OLIMEX/iCE40HX1K-EVB/README.md

# iCE40HX1K-EVB
FPGA development board made with KiCAD
