OLIMEX/iCE40HX1K-EVB/modules/iCE40-ADC/README.md

# Repository re-located here: https://github.com/OLIMEX/iCE40-ADC/tree/master
