OLIMEX/iCE40HX1K-EVB/demo/ice40hx1k-evb/README

This example is for iCE40HX1K-EVB board 

www.olimex.com/wiki/iCE40HX1K-EVB

you need OLIMEXINO-32U4 set as programmer to program the board
