OLIMEX/iCE40HX1K-EVB/(threads)

Thread 2 (2017-09-08):

Request guide to program FPGA board with generic Arduino

electronut, 2017-09-08:
The current documentation assumes that Olimexduino is used as a programmer with the custom cable.

This board would be much more user friendly if some guidance was provided on making it work with a generic Arduino - for example an Arduino Pro Mini.

DanKoloff, 2017-09-08:
OLIMEXINO-328 is quite generic. It is quite similar to Arduino UNO R3. You can use the guide as a reference and use any Arduino board. Furthermore, it looks like Arduino Pro Mini is a retired product: https://store.arduino.cc/arduino-pro-mini

electronut, 2017-09-08:
Pro Mini clones are still widely used. I also tried with an Arduino Uno + level shifter, but was unable to make it work. I'll try some more and post my results.

I've seen someone using Raspberry Pi's SPI ports with icestorm tools to program this board. Any help there would be very useful as well.

I think having multiple options to program this board could be very helpful. Thanks.

electronut, 2017-09-11:
I really wish some sort of programmer (USB/SPI or serial) was embedded in this board. At this point I've given up and am getting the dev board from Lattice.

Closed 2017-09-11.

Thread 3 (2017-11-07):

ADC module availability

kelu124, 2017-11-07:
Hi Olimex!
I saw you had a ICE40 100Msps ADC extension board - but couldn't find the link to the repo. Would you still have it?
Thanks in advance!

TsvetanUsunov, 2017-11-08:
all modules are here https://www.olimex.com/Products/FPGA/iCE40/

DanKoloff, 2017-11-08:
@kelu124 I removed it by mistake last week, it is now up again. Sorry.

kelu124, 2017-11-09:
Thanks a bunch!

Closed 2017-11-08.

Thread 6 (2018-06-18):

Programing ICE40HX1K-EVB

ilkerparmaksiz, 2018-06-18:
HI there, I am trying to program this FPGA by arduino due. I uploaded the initial sketch to arduino due after that , the LED close to PGM1 connections on the board turn on.  Whenever I try to program it by using example on ICE40HX1K-EVB, it connects to arduino due , says bulk erased , and programing ...  I also can see the RX led on the arduino blinks. However ,this continues forever , and i am not sure what to do next about this. I wonder if you guys have any suggestion?  For SPIFlash i am using latest version.

DanKoloff, 2018-06-19:
What sketch do you upload to the Due? Our programmer sketch is meant for OLIMEXINO-32u4 and might not work properly without changes with other boards.

ilkerparmaksiz, 2018-06-20:
i upload the iceprog sketch from the ice40hx1-evb library. For Arduino due,  i am making  following changes;
#define CDONE 12
#define RESET 11
#define CS  10
The problem i think is I somehow can not make successful connection with flash memory. I use the SPIFlash Memory library that they recommend in the sketch, It keeps saying " flash memory chip is not initialized  check wiring or may chip is not supported"

ilkerparmaksiz, 2018-06-20:
also flash memory returning "0" for every SPI transfer

ilkerparmaksiz, 2018-06-21:
we also have test it  with  raspberry pi 3 as it is shown on the olimex page. However we get the same response Flash memory is not detected. How possible is the flash memory has problem?

ilkerparmaksiz, 2018-06-21:
also the following connections you guys give for the programming connector is wrong.
https://www.olimex.com/wiki/File:ICE40PGM.jpg
those are the correct connections i have tested by hand, and get them from ur schematics
https://pasteboard.co/HqZ9sSj.png.

Closed 2020-05-27.

Thread 11 (2021-09-28):

SRAM programming using FT2232 & Icestorm's iceprog

regymm, 2021-09-28:
Hi, I made a slightly modified version of the board without much changing(downloading circuit unchanged), and now I have some problems with SRAM programming: moving R9 to R19 doesn't work. I'm using a custom FT2232H downloader and iceprog tool. Flash programming works so I think my downloader and FPGA chip have no problem.

If I unmount both R9 and R19, and manually swapping MISO/MOSI of the FT2232H, SRAM programming will work. However, whenever the R19 is populated(SDI and SDO of the FPGA are shorted), programing will fail(DONE not high after run iceprog).

Any ideas about the problem? Thanks in advance.

regymm, 2021-09-28:
I also compared my case with the [description in iceprog tool](http://www.clifford.at/gallery/2014-elektronik/IMG_20141115_183838), seems they didn't directly short the FPGA's two pins -- this is the only difference between their and my setup as far as I found.

DanKoloff, 2021-09-30:
So the unmodified version programs fine but the *slightly modified version* doesn't program. I'd suggest describing what exactly you modified and start from there.

regymm, 2021-09-30:
Thanks for your reply. My modification is in [the fork](https://github.com/regymm/iCE40HX1K-EVB), with only an FT2232H downloader([this one](https://github.com/regymm/ymmcu-ft2232)) interface added.

Thread 12 (2022-02-25):

olimexino-32u4: firmware compilation errors in iceprog (loopProg, loopBridge)

r1mk, 2022-02-25:
Hi,
The firmware compilation using arduino IDE and/or platformio fails (fedora 35 / gcc g++ 11.2.1):
(here with platformio)
```
src/iceprog.cpp: In function 'void loop()':
src/iceprog.cpp:120:15: error: 'loopProg' was not declared in this scope
   if (isProg) loopProg();
(...)
src/iceprog.cpp:121:8: error: 'loopBridge' was not declared in this scope
   else loopBridge();
```

proposed solution : add the following declarations in `iceprog.cpp` (and/or `iceprog.ino`) after `void readpage(uint16_t adr);` (L87)
```
void loopProg(void);
void loopBridge(void);
```

DanKoloff, 2022-02-25:
We haven't tested it with platformio, only Arduino IDE.

Did you download all files?

Did you install SPIMemory library?

r1mk, 2022-02-25:
Sorry! I was pretty sure that I had the same problem with both "tracks" but the problem seems to affect only platformio.

I've done it again on another machine with arduino 1.6.9 + SPI 2.2.0 added + the original iceprog.ino loaded and the compilation is ok without the fix.
Mea culpa!

The compilation error with platformio is only linked to the code of iceprog.ino (through the `src/iceprog.cpp` link)
Except for loopBridge() and loopProg() the other important functions are correctly declared at the top of the file (from secerase to readpage). The platformio compiler complains because these 2 only appear below their parent function loop() with no previous declaration.

By the way, [iceprog/iceprog.cpp](https://github.com/OLIMEX/iCE40HX1K-EVB/blob/master/programmer/olimexino-32u4%20firmware/iceprog/iceprog.cpp) seems to be a broken link file (git thinks it a normal file with a path inside).

Thread 17 (2024-10-20):

Followed the "Get started under Linux" guide, can't get LEDs to blink

kayprish, 2024-10-20:
I've tried following this guide:

https://www.olimex.com/wiki/ICE40HX1K-EVB#Get_started_under_Linux

So far, I believe I've managed to get everything working, the 32u4 is working, I've managed to upload iceprog.ino to it.
I've managed to install iceprogduino on my system. As well as all the dependencies.

I've copied this directory to another location: https://github.com/OLIMEX/iCE40HX1K-EVB/tree/master/demo/ice40hx1k-evb
This is the demo of the board that's supposed to display two blinking LEDs.

I ran `make` and `make prog`. The output indicates no issue. However when I program the board, I don't get blinking LEDs 1 and 2.
Instead they both give off a faint light that doesn't change, shown in the image below.

The board:
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

DanKoloff, 2024-10-22:
The demo was made for iCE40HX1K and you seem to have iCE40HX8K. The LEDs are at different pins, probably just using the proper pins for the LEDs would do the job.

In iCE40HX1K the LEDs are at pins B41 and R52. In iCE40HX8K the LEDs are at PIO2_42/B101 and PIO2_43/B102.

kayprish, 2024-10-23:
Will try, I don't have access to the board currently but I will close as soon as I try and it works out.

kayprish, 2024-10-28:
Yep, my mistake, I just deleted the whole HX1K example directory, and replaced it with the contents of this directory.
https://github.com/OLIMEX/iCE40HX8K-EVB/tree/master/demo/ice40hx8k-evb
Everything works, closing this issue.

Closed 2024-10-28.
