OLIMEX/iCE40HX1K-EVB/iCE40HX1K-EVB_Rev_B.pdf

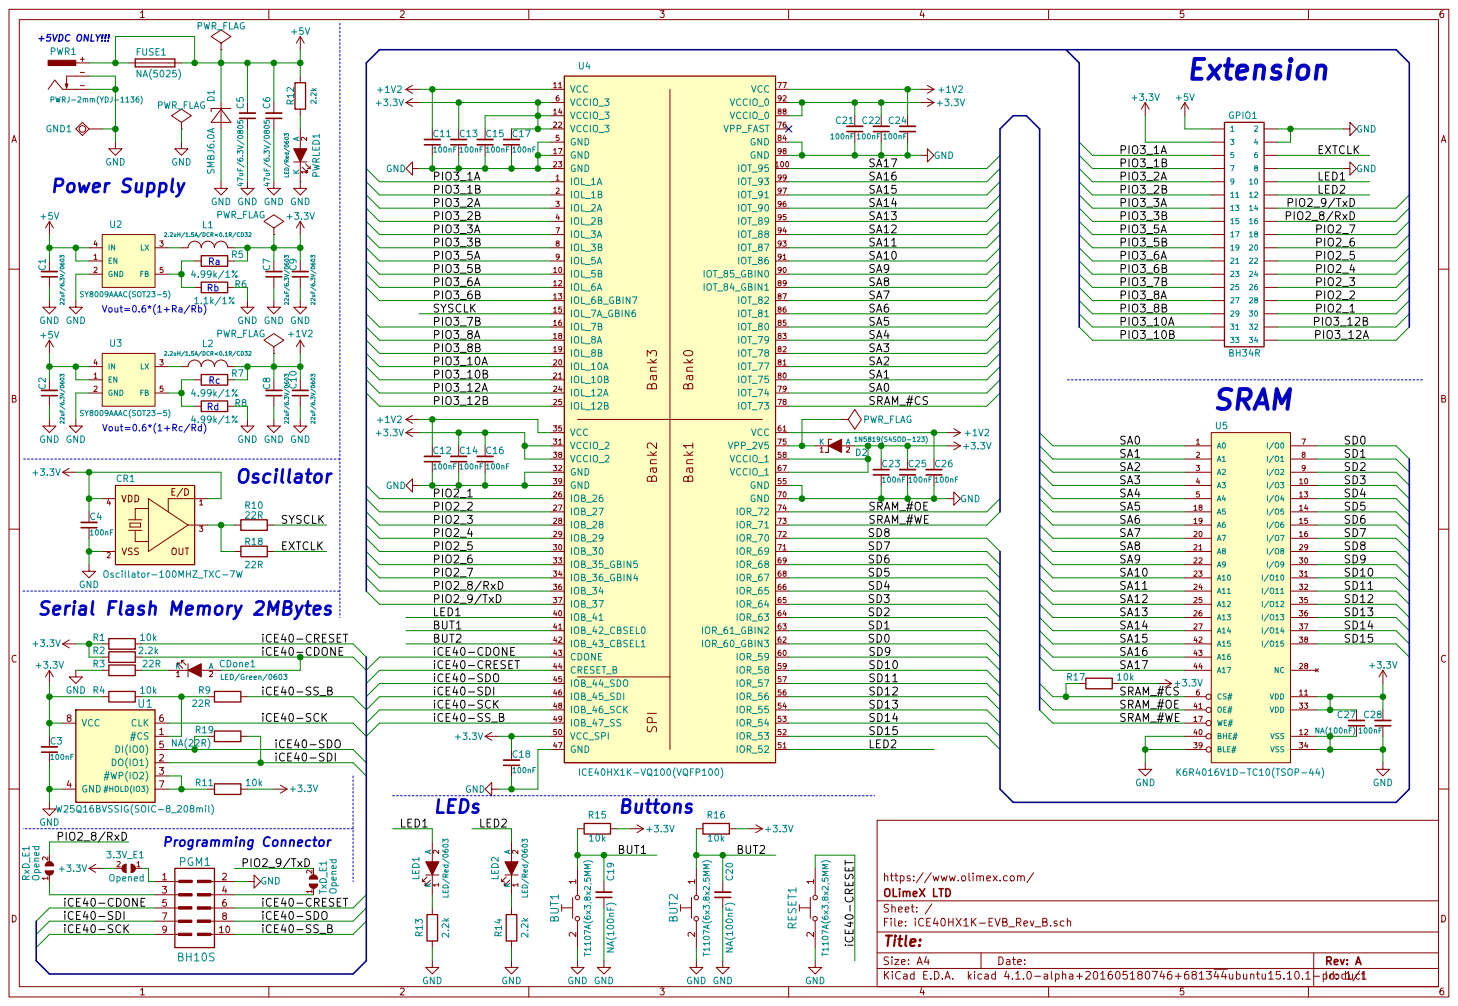
[picture p21: page 1]

2 PWRLED1 LED/Red/0603 R12 2.2k GND C1 22uF/6.3V/0603 GND

https://www.olimex.com/
File: iCE40HX1K-EVB_Rev_B.sch Sheet: / OLimeX LTD
