OLIMEX/iCE40HX1K-EVB/ICE40-1KEVB_Rev_A.pdf

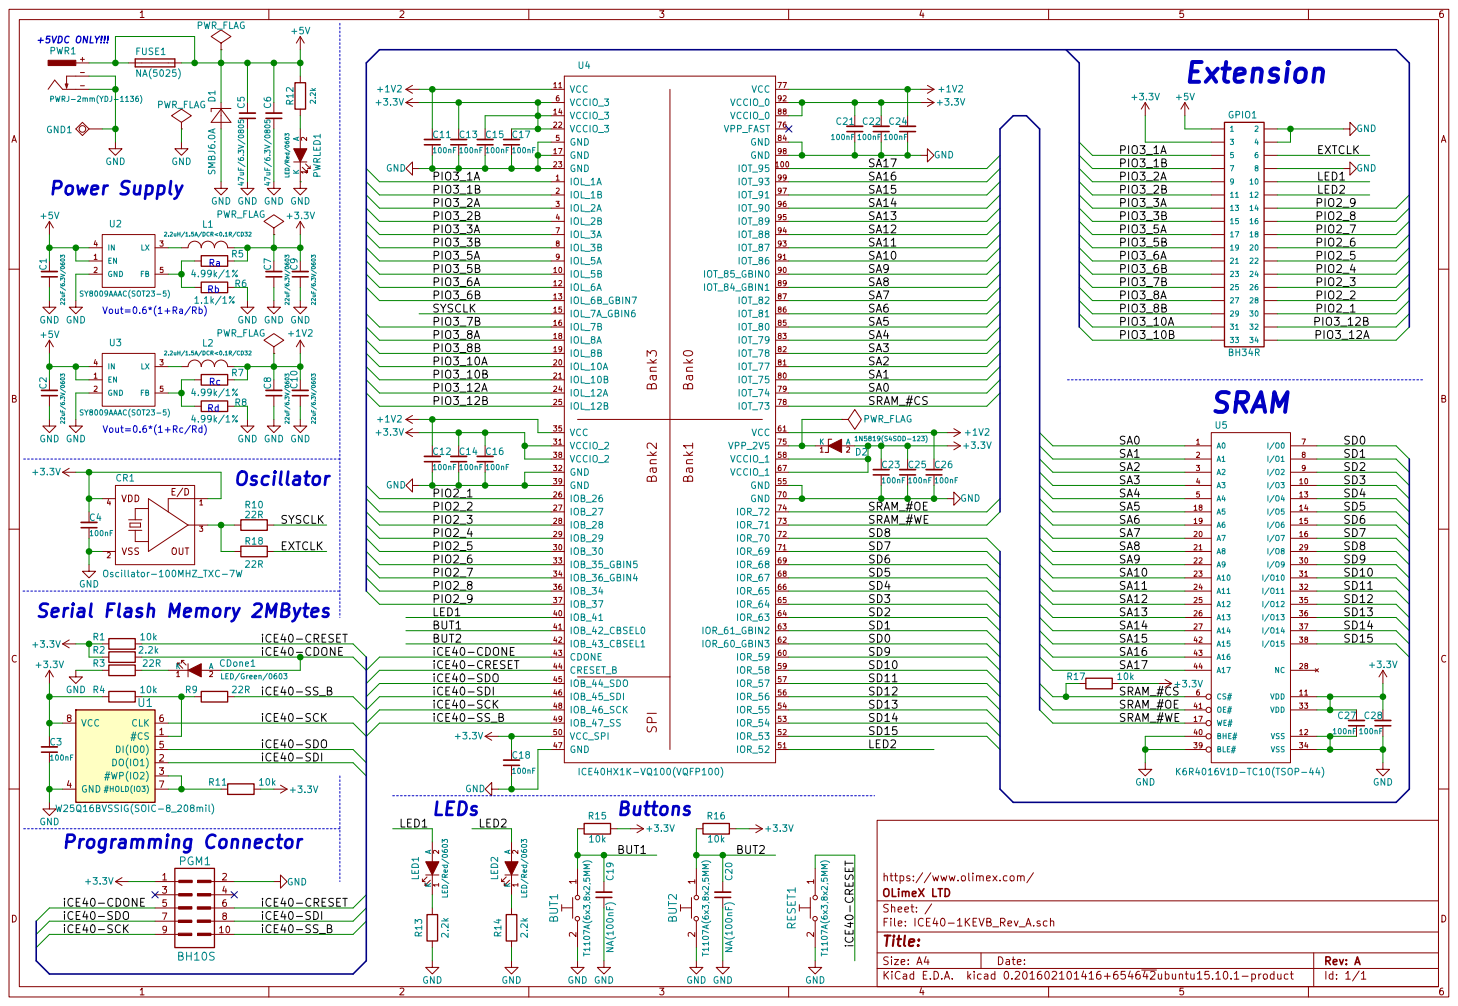
[picture p22: page 1]

2 PWRLED1 LED/Red/0603 R12 2.2k GND C1 22uF/6.3V/0603 GND

https://www.olimex.com/
File: ICE40-1KEVB_Rev_A.sch Sheet: / OLimeX LTD
