OLIMEX/iCE40HX1K-EVB/iCE40HX1K-EVB_Rev_B.kicad_pcb

## KiCad design iCE40HX1K-EVB_Rev_B.kicad_pcb (2016-06-30)

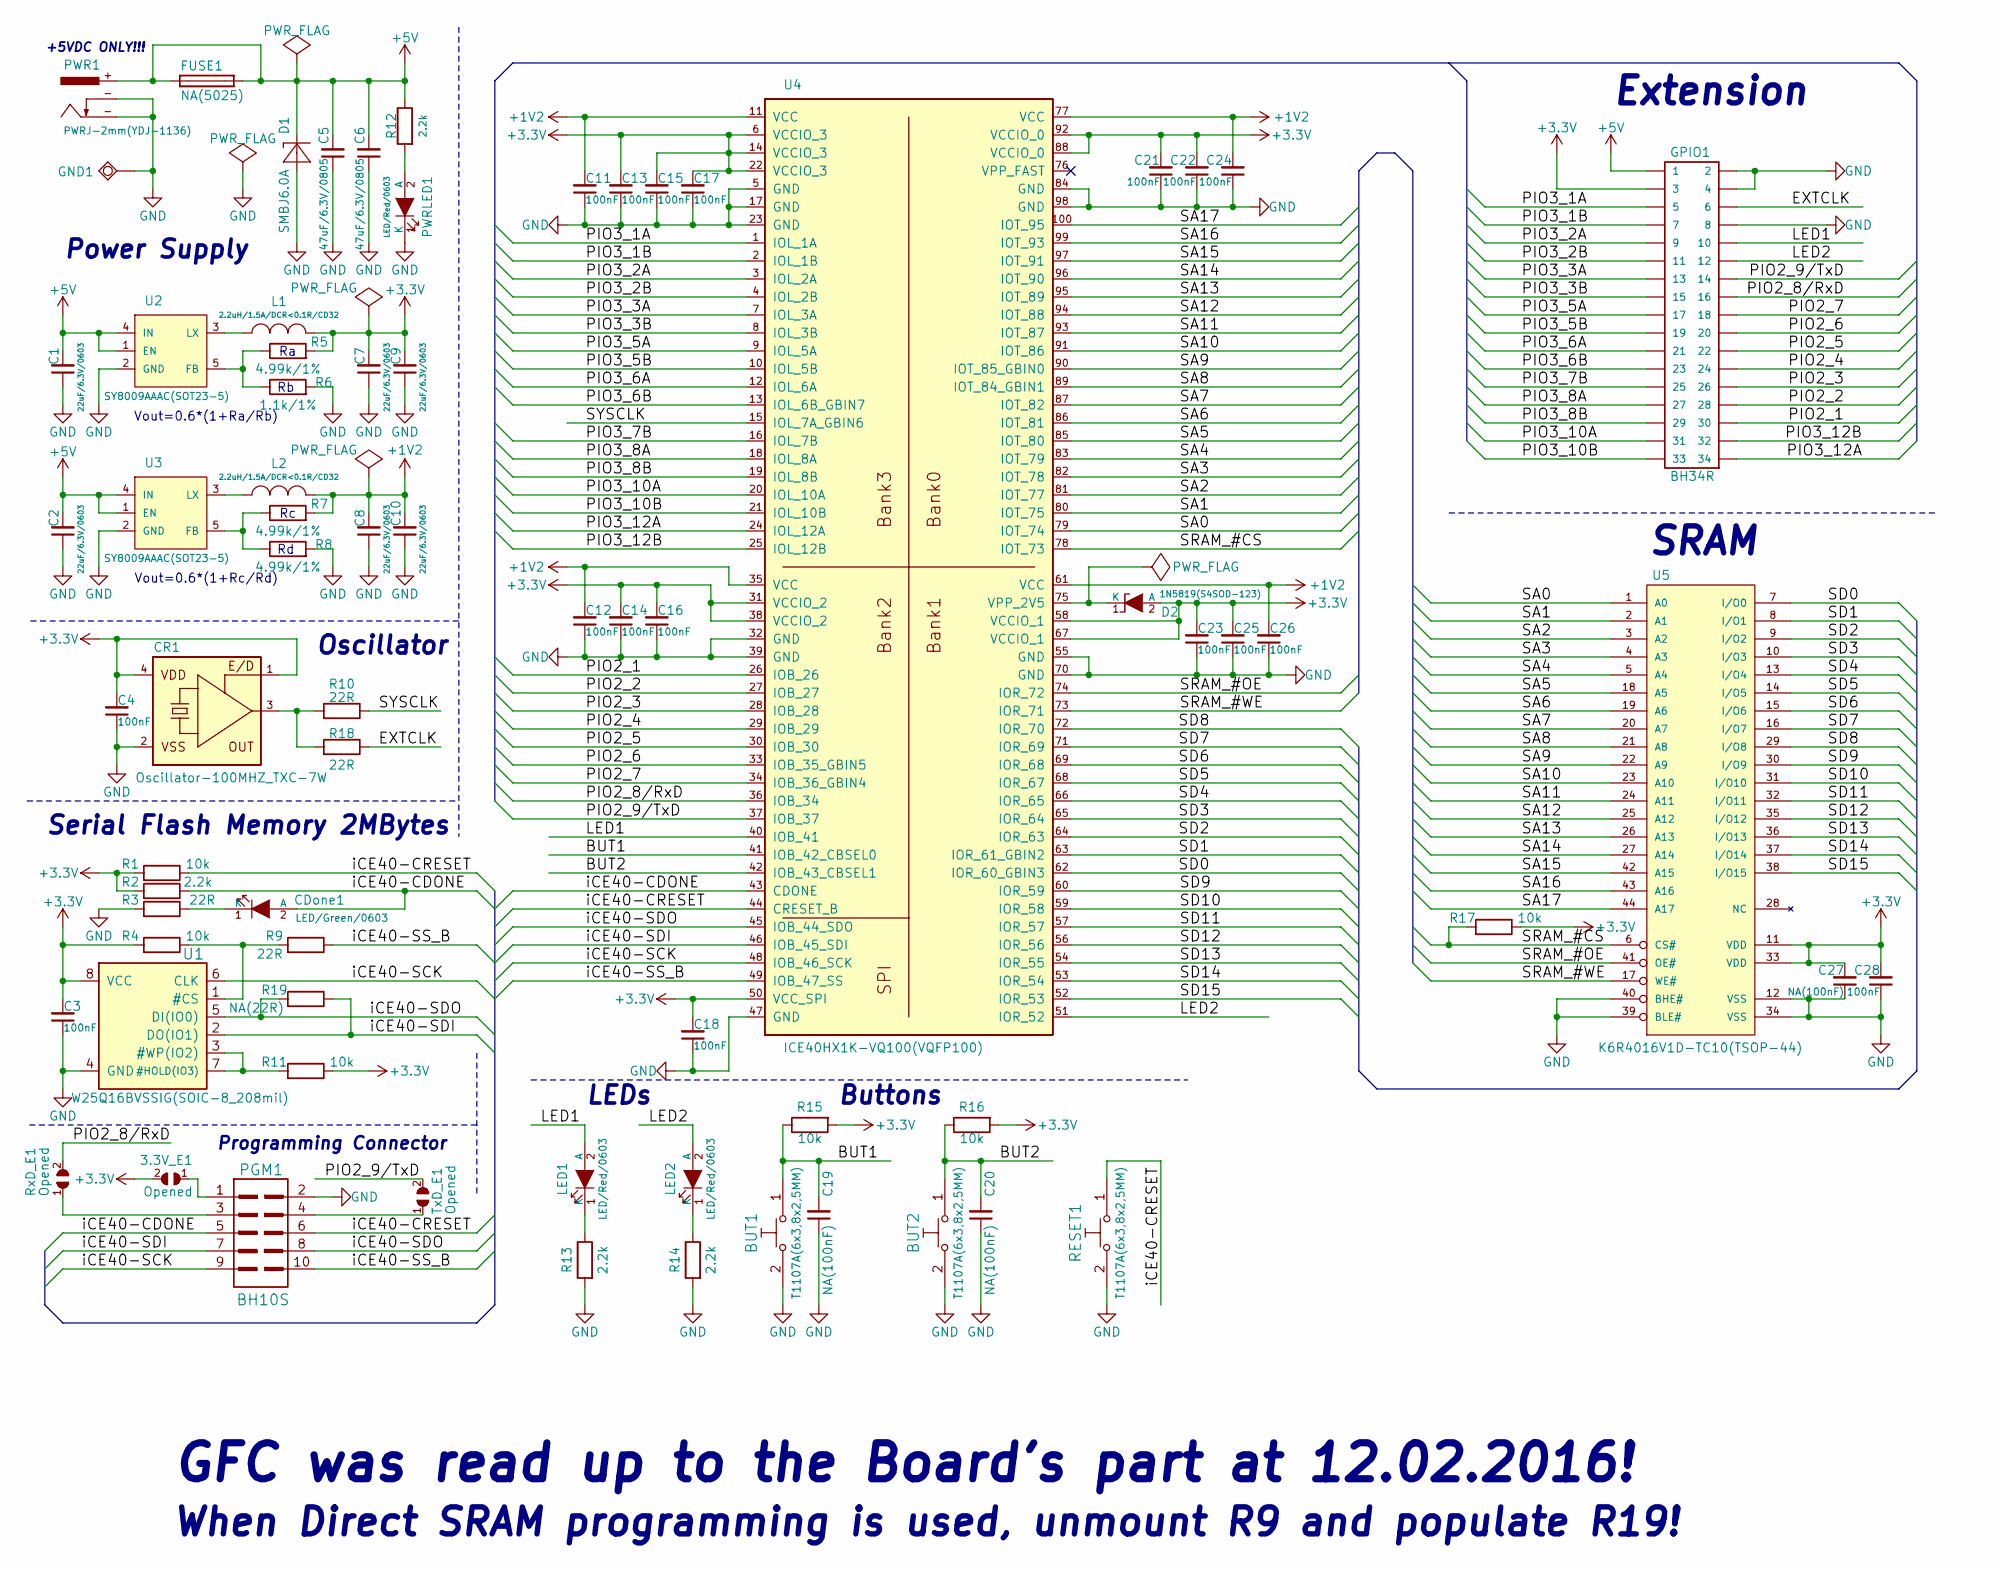
[picture p23: schematic iCE40HX1K-EVB_Rev_B.sch]

Parts:
3.3V_E1: Opened; SJ
BUT1, BUT2: T1107A(6x3,8x2,5MM)
C1, C2, C7, C8, C9, C10: 22uF/6.3V/0603; C_0603_5MIL_DWS
C3, C4, C11, C12, C13, C14, C15, C16, C17, C18, C21, C22, C23, C24, C25, C26, C28: 100nF; C_0402_5MIL_DWS
C5, C6: 47uF/6.3V/0805; C_0805_5MIL_DWS
C19, C20, C27: NA(100nF); C_0402_5MIL_DWS
CDone1: LED/Green/0603; LED_0603_KA
CR1: Oscillator-100MHZ_TXC-7W; Oscillator_7.0x5.0mm
D1: SMBJ6.0A; DO214AA
D2: 1N5819(S4SOD-123); SOD-123_1C-2A_KA
FUSE1: NA(5025); FUSE-5025
GND1: TESTPAD; TEST_PAD40x70_SQUARE
GPIO1: BH34R
L1, L2: 2.2uH/1.5A/DCR<0.1R/CD32; CD32
LED1, LED2: LED/Red/0603; LED_0603_KA
PGM1: BH10S; UEXT_ML10
PWR1: PWRJ-2mm(YDJ-1136)
PWRLED1: LED/Red/0603; LED_0603_KA
R1, R4, R11, R15, R16, R17: 10k; R_0402_5MIL_DWS
R2, R12, R13, R14: 2.2k; R_0402_5MIL_DWS
R3, R9, R10, R18: 22R; R_0402_5MIL_DWS
R5, R7, R8: 4.99k/1%; R_0402_5MIL_DWS
R6: 1.1k/1%; R_0402_5MIL_DWS
R19: NA(22R); R_0402_5MIL_DWS
RESET1: T1107A(6x3,8x2,5MM)
RxD_E1: Opened; SJ
TxD_E1: Opened; SJ
U1: W25Q16BVSSIG(SOIC-8_208mil); SO-8_208mil
U2, U3: SY8009AAAC(SOT23-5); SOT-23-5
U4: ICE40HX1K-VQ100(VQFP100); VQFP100_Pitch-0.5mm_Dimensions-16.00x16.00x1.20mm
U5: K6R4016V1D-TC10(TSOP-44); TSOP-44_Pitch-0.80mm_18.80x11.80x1.20mm

Connections:
+1V2: C8.2, C10.2, C11.2, C12.2, C24.2, C26.2, L2.1, R7.2, U4.11 (VCC), U4.35 (VCC), U4.61 (VCC), U4.77 (VCC)
+3V3: 3.3V_E1.2, C3.2, C4.2, C7.2, C9.2, C13.2, C14.2, C15.2, C16.2, C17.2, C18.2, C21.2, C22.2, C23.2, C25.2, C27.2, C28.2, CR1.1 (E/D), CR1.4 (VDD), D2.2 (A), GPIO1.3, L1.1, R1.2, R2.2, R4.2, R5.2, R11.1, R15.2, R16.2, R17.1, U1.8 (VCC), U4.6 (VCCIO_3), U4.14 (VCCIO_3), U4.22 (VCCIO_3), U4.31 (VCCIO_2), U4.38 (VCCIO_2), U4.50 (VCC_SPI), U4.58 (VCCIO_1), U4.67 (VCCIO_1), U4.88 (VCCIO_0), U4.92 (VCCIO_0), U5.11 (VDD), U5.33 (VDD)
+5V: C1.2, C2.2, C5.2, C6.2, D1.C, FUSE1.1, FUSE1.2, GPIO1.1, PWR1.+, R12.1, U2.1 (EN), U2.4 (IN), U3.1 (EN), U3.4 (IN)
/BUT1: BUT1.1, C19.2, R15.1, U4.41 (IOB_42_CBSEL0)
/BUT2: BUT2.1, C20.2, R16.1, U4.42 (IOB_43_CBSEL1)
/EXTCLK: GPIO1.6, R18.1
/LED1: GPIO1.10, LED1.2 (A), U4.40 (IOB_41)
/LED2: GPIO1.12, LED2.2 (A), U4.51 (IOR_52)
/PIO2_1: GPIO1.30, U4.26 (IOB_26)
/PIO2_2: GPIO1.28, U4.27 (IOB_27)
/PIO2_3: GPIO1.26, U4.28 (IOB_28)
/PIO2_4: GPIO1.24, U4.29 (IOB_29)
/PIO2_5: GPIO1.22, U4.30 (IOB_30)
/PIO2_6: GPIO1.20, U4.33 (IOB_35_GBIN5)
/PIO2_7: GPIO1.18, U4.34 (IOB_36_GBIN4)
/PIO2_8/RxD: GPIO1.16, RxD_E1.2, U4.36 (IOB_34)
/PIO2_9/TxD: GPIO1.14, TxD_E1.2, U4.37 (IOB_37)
/PIO3_1A: GPIO1.5, U4.1 (IOL_1A)
/PIO3_1B: GPIO1.7, U4.2 (IOL_1B)
/PIO3_2A: GPIO1.9, U4.3 (IOL_2A)
/PIO3_2B: GPIO1.11, U4.4 (IOL_2B)
/PIO3_3A: GPIO1.13, U4.7 (IOL_3A)
/PIO3_3B: GPIO1.15, U4.8 (IOL_3B)
/PIO3_5A: GPIO1.17, U4.9 (IOL_5A)
/PIO3_5B: GPIO1.19, U4.10 (IOL_5B)
/PIO3_6A: GPIO1.21, U4.12 (IOL_6A)
/PIO3_6B: GPIO1.23, U4.13 (IOL_6B_GBIN7)
/PIO3_7B: GPIO1.25, U4.16 (IOL_7B)
/PIO3_8A: GPIO1.27, U4.18 (IOL_8A)
/PIO3_8B: GPIO1.29, U4.19 (IOL_8B)
/PIO3_10A: GPIO1.31, U4.20 (IOL_10A)
/PIO3_10B: GPIO1.33, U4.21 (IOL_10B)
/PIO3_12A: GPIO1.34, U4.24 (IOL_12A)
/PIO3_12B: GPIO1.32, U4.25 (IOL_12B)
/SA0: U4.79 (IOT_74), U5.1 (A0)
/SA1: U4.80 (IOT_75), U5.2 (A1)
/SA2: U4.81 (IOT_77), U5.3 (A2)
/SA3: U4.82 (IOT_78), U5.4 (A3)
/SA4: U4.83 (IOT_79), U5.5 (A4)
/SA5: U4.85 (IOT_80), U5.18 (A5)
/SA6: U4.86 (IOT_81), U5.19 (A6)
/SA7: U4.87 (IOT_82), U5.20 (A7)
/SA8: U4.89 (IOT_84_GBIN1), U5.21 (A8)
/SA9: U4.90 (IOT_85_GBIN0), U5.22 (A9)
/SA10: U4.91 (IOT_86), U5.23 (A10)
/SA11: U4.93 (IOT_87), U5.24 (A11)
/SA12: U4.94 (IOT_88), U5.25 (A12)
/SA13: U4.95 (IOT_89), U5.26 (A13)
/SA14: U4.96 (IOT_90), U5.27 (A14)
/SA15: U4.97 (IOT_91), U5.42 (A15)
/SA16: U4.99 (IOT_93), U5.43 (A16)
/SA17: U4.100 (IOT_95), U5.44 (A17)
/SD0: U4.62 (IOR_60_GBIN3), U5.7 (I/O0)
/SD1: U4.63 (IOR_61_GBIN2), U5.8 (I/O1)
/SD2: U4.64 (IOR_63), U5.9 (I/O2)
/SD3: U4.65 (IOR_64), U5.10 (I/O3)
/SD4: U4.66 (IOR_65), U5.13 (I/O4)
/SD5: U4.68 (IOR_67), U5.14 (I/O5)
/SD6: U4.69 (IOR_68), U5.15 (I/O6)
/SD7: U4.71 (IOR_69), U5.16 (I/O7)
/SD8: U4.72 (IOR_70), U5.29 (I/O8)
/SD9: U4.60 (IOR_59), U5.30 (I/O9)
/SD10: U4.59 (IOR_58), U5.31 (I/O10)
/SD11: U4.57 (IOR_57), U5.32 (I/O11)
/SD12: U4.56 (IOR_56), U5.35 (I/O12)
/SD13: U4.54 (IOR_55), U5.36 (I/O13)
/SD14: U4.53 (IOR_54), U5.37 (I/O14)
/SD15: U4.52 (IOR_53), U5.38 (I/O15)
/SRAM_#CS: R17.2, U4.78 (IOT_73), U5.6 (CS#)
/SRAM_#OE: U4.74 (IOR_72), U5.41 (OE#)
/SRAM_#WE: U4.73 (IOR_71), U5.17 (WE#)
/SYSCLK: R10.1, U4.15 (IOL_7A_GBIN6)
/iCE40-CDONE: CDone1.2 (A), PGM1.5, R2.1, U4.43 (CDONE)
/iCE40-CRESET: PGM1.6, R1.1, RESET1.1, U4.44 (CRESET_B)
/iCE40-SCK: PGM1.9, U1.6 (CLK), U4.48 (IOB_46_SCK)
/iCE40-SDI: PGM1.7, R19.1, U1.2 (DO(IO1)), U4.46 (IOB_45_SDI)
/iCE40-SDO: PGM1.8, R19.2, U1.5 (DI(IO0)), U4.45 (IOB_44_SDO)
/iCE40-SS_B: PGM1.10, R9.1, U4.49 (IOB_47_SS)
GND: BUT1.2, BUT2.2, C1.1, C2.1, C3.1, C4.1, C5.1, C6.1, C7.1, C8.1, C9.1, C10.1, C11.1, C12.1, C13.1, C14.1, C15.1, C16.1, C17.1, C18.1, C19.1, C20.1, C21.1, C22.1, C23.1, C24.1, C25.1, C26.1, C27.1, C28.1, CR1.2 (VSS), D1.A, GND1.1, GPIO1.2, GPIO1.4, GPIO1.8, PGM1.2, PWR1.-, PWRLED1.1 (K), R3.2, R6.2, R8.2, R13.2, R14.2, RESET1.2, U1.4 (GND), U2.2 (GND), U3.2 (GND), U4.5 (GND), U4.17 (GND), U4.23 (GND), U4.32 (GND), U4.39 (GND), U4.47 (GND), U4.55 (GND), U4.70 (GND), U4.84 (GND), U4.98 (GND), U5.12 (VSS), U5.34 (VSS), U5.39 (BLE#), U5.40 (BHE#)
unnamed: 3.3V_E1.1, PGM1.1
unnamed: CDone1.1 (K), R3.1
unnamed: CR1.3 (OUT), R10.2, R18.2
unnamed: D2.1 (K), U4.75 (VPP_2V5)
unnamed: L1.2, U2.3 (LX)
unnamed: L2.2, U3.3 (LX)
unnamed: LED1.1 (K), R13.1
unnamed: LED2.1 (K), R14.1
unnamed: PGM1.3, RxD_E1.1
unnamed: PGM1.4, TxD_E1.1
unnamed: PWRLED1.2 (A), R12.2
unnamed: R4.1, R9.2, U1.1 (#CS)
unnamed: R5.1, R6.1, U2.5 (FB)
unnamed: R7.1, R8.1, U3.5 (FB)
unnamed: R11.2, U1.3 (#WP(IO2)), U1.7 (#HOLD(IO3))

Notes on the sheet:
Power Supply
Vout=0.6*(1+Ra/Rb)
Extension
GFC was read up to the Board's part at 12.02.2016!
+5VDC ONLY!!!
Vout=0.6*(1+Rc/Rd)
SRAM
Oscillator
Serial Flash Memory 2MBytes
Programming Connector
LEDs
Buttons
When Direct SRAM programming is used, unmount R9 and populate R19!

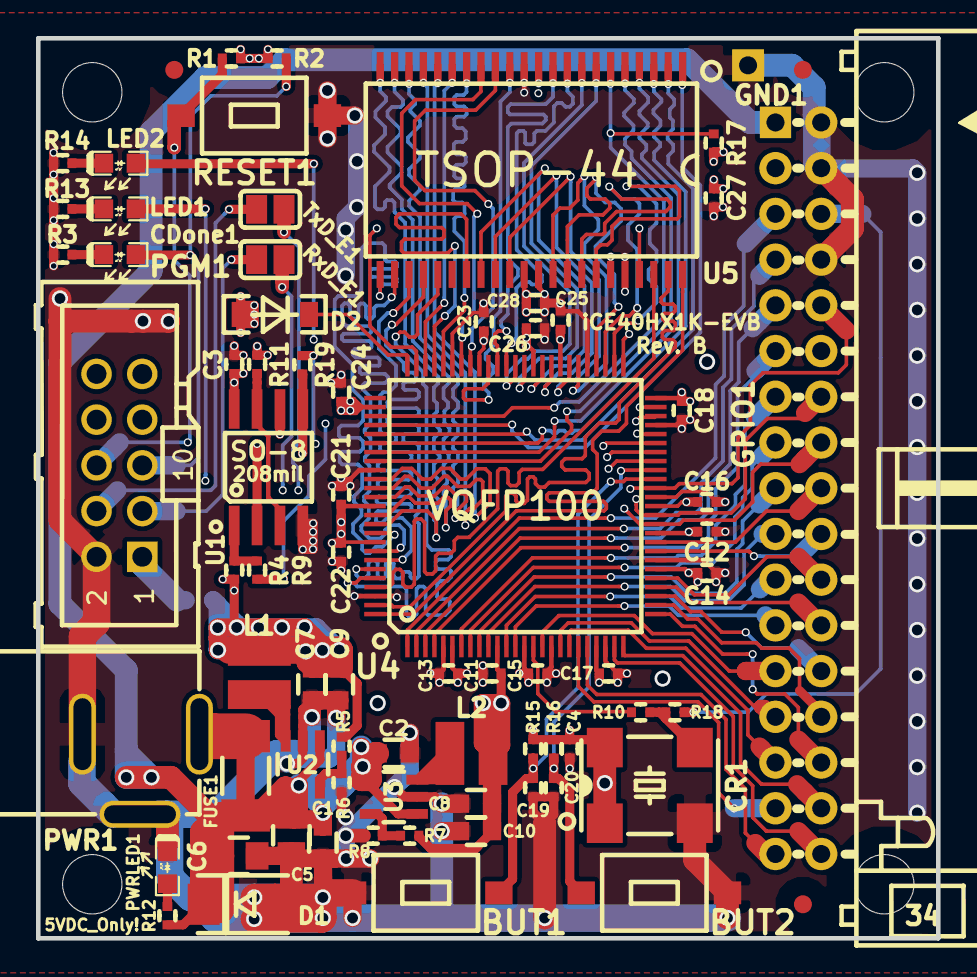
[picture p24: board iCE40HX1K-EVB_Rev_B.kicad_pcb from above]

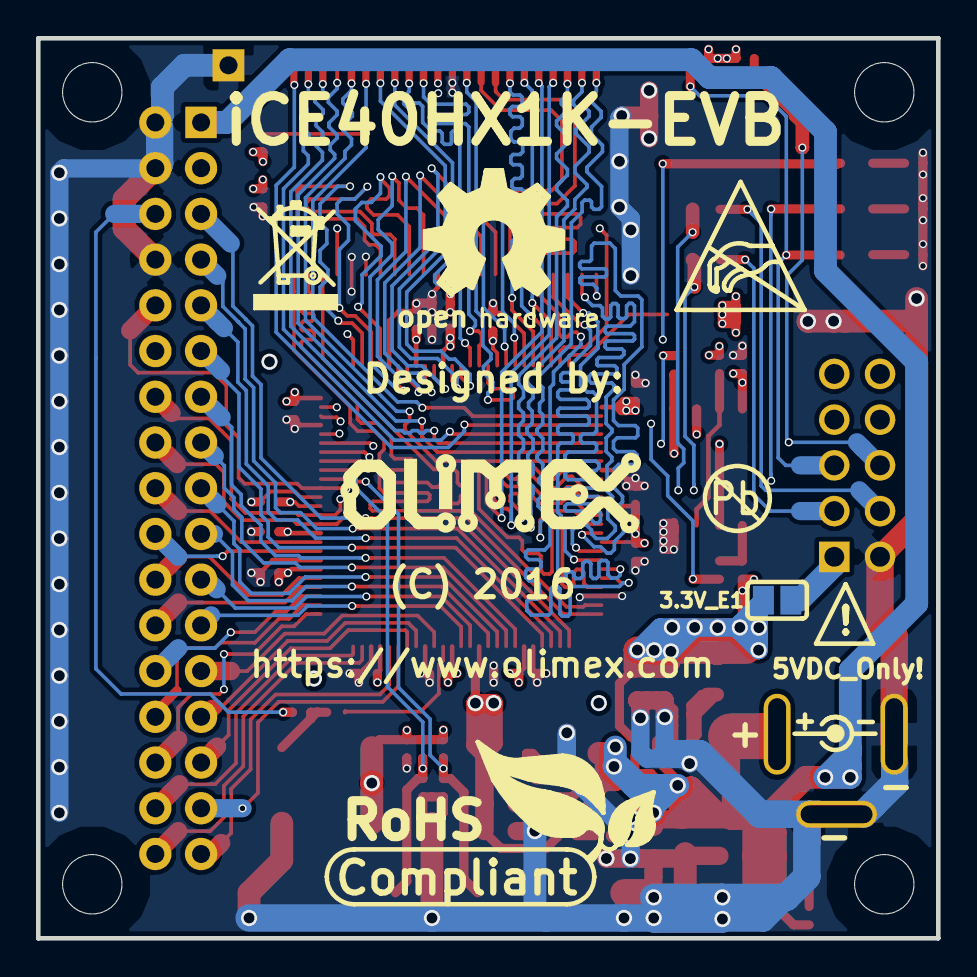
[picture p25: board iCE40HX1K-EVB_Rev_B.kicad_pcb from below]

Board: 4 copper layers, 50.0 x 50.0 mm, 78 parts (3 on the bottom side), 94 nets.

Other parts of the board:
MountingHole: Mounting_hole_3.3mm
MountingHole#2, MountingHole#3, MountingHole#4: Mounting_hole_3.3mm
Ref**: Val**; LOGO_ANTISTATIC_1
Ref**#2: Val**; LOGO_ROHS_1
