OLIMEX/iCE40HX1K-EVB/windows/ice40blinkingled/ice40blinkingled_pin.pcf

set_io CLK 15
set_io BUT1 41
set_io BUT2 42
set_io LED1 40
set_io LED2 51
