OLIMEX/iCE40HX1K-EVB/windows/ice40blinkingled/ice40blinkingled_Implmnt/sbt/outputs/simulation_netlist/led_but_ex1_sbt.v

// ******************************************************************************

// iCEcube Netlister

// Version:            2015.08.27744

// Build Date:         Oct 14 2015 00:55:30

// File Generated:     Jul 18 2016 09:41:18

// Purpose:            Post-Route Verilog/VHDL netlist for timing simulation

// Copyright (C) 2006-2010 by Lattice Semiconductor Corp. All rights reserved.

// ******************************************************************************

// Verilog file for cell "led_but_ex1" view "INTERFACE"

module led_but_ex1 (
    LED2,
    CLK,
    BUT1,
    LED1,
    BUT2);

    output LED2;
    input CLK;
    input BUT1;
    output LED1;
    input BUT2;

    wire N__2577;
    wire N__2576;
    wire N__2575;
    wire N__2566;
    wire N__2565;
    wire N__2564;
    wire N__2557;
    wire N__2556;
    wire N__2555;
    wire N__2548;
    wire N__2547;
    wire N__2546;
    wire N__2539;
    wire N__2538;
    wire N__2537;
    wire N__2520;
    wire N__2519;
    wire N__2516;
    wire N__2513;
    wire N__2510;
    wire N__2505;
    wire N__2502;
    wire N__2501;
    wire N__2498;
    wire N__2495;
    wire N__2492;
    wire N__2487;
    wire N__2484;
    wire N__2483;
    wire N__2480;
    wire N__2477;
    wire N__2474;
    wire N__2469;
    wire N__2466;
    wire N__2465;
    wire N__2462;
    wire N__2459;
    wire N__2456;
    wire N__2451;
    wire N__2448;
    wire N__2447;
    wire N__2444;
    wire N__2441;
    wire N__2438;
    wire N__2433;
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
    wire BUT2_c;
    wire BUT2_rZ0;
    wire clk_divZ0Z_1;
    wire clk_divZ0Z_0;
    wire bfn_5_7_0_;
    wire clk_divZ0Z_2;
    wire clk_div_1_cry_1;
    wire clk_divZ0Z_3;
    wire clk_div_1_cry_2;
    wire clk_divZ0Z_4;
    wire clk_div_1_cry_3;
    wire clk_divZ0Z_5;
    wire clk_div_1_cry_4;
    wire clk_divZ0Z_6;
    wire clk_div_1_cry_5;
    wire clk_divZ0Z_7;
    wire clk_div_1_cry_6;
    wire clk_divZ0Z_8;
    wire clk_div_1_cry_7;
    wire clk_div_1_cry_8;
    wire clk_divZ0Z_9;
    wire bfn_5_8_0_;
    wire clk_div_1_cry_9;
    wire clk_divZ0Z_10;
    wire BUT1_c;
    wire BUT1_rZ0;
    wire CLK_c_g;
    wire N_16_g;
    wire _gnd_net_;

    PRE_IO_GBUF CLK_ibuf_gb_io_preiogbuf (
            .PADSIGNALTOGLOBALBUFFER(N__2575),
            .GLOBALBUFFEROUTPUT(CLK_c_g));
    IO_PAD CLK_ibuf_gb_io_iopad (
            .OE(N__2577),
            .DIN(N__2576),
            .DOUT(N__2575),
            .PACKAGEPIN(CLK));
    defparam CLK_ibuf_gb_io_preio.NEG_TRIGGER=1'b0;
    defparam CLK_ibuf_gb_io_preio.PIN_TYPE=6'b000001;
    PRE_IO CLK_ibuf_gb_io_preio (
            .PADOEN(N__2577),
            .PADOUT(N__2576),
            .PADIN(N__2575),
            .CLOCKENABLE(),
            .DOUT1(),
            .OUTPUTENABLE(),
            .DIN0(),
            .DOUT0(),
            .INPUTCLK(),
            .LATCHINPUTVALUE(),
            .DIN1(),
            .OUTPUTCLK());
    IO_PAD BUT2_ibuf_iopad (
            .OE(N__2566),
            .DIN(N__2565),
            .DOUT(N__2564),
            .PACKAGEPIN(BUT2));
    defparam BUT2_ibuf_preio.NEG_TRIGGER=1'b0;
    defparam BUT2_ibuf_preio.PIN_TYPE=6'b000001;
    PRE_IO BUT2_ibuf_preio (
            .PADOEN(N__2566),
            .PADOUT(N__2565),
            .PADIN(N__2564),
            .CLOCKENABLE(),
            .DOUT1(),
            .OUTPUTENABLE(),
            .DIN0(BUT2_c),
            .DOUT0(),
            .INPUTCLK(),
            .LATCHINPUTVALUE(),
            .DIN1(),
            .OUTPUTCLK());
    IO_PAD BUT1_ibuf_iopad (
            .OE(N__2557),
            .DIN(N__2556),
            .DOUT(N__2555),
            .PACKAGEPIN(BUT1));
    defparam BUT1_ibuf_preio.NEG_TRIGGER=1'b0;
    defparam BUT1_ibuf_preio.PIN_TYPE=6'b000001;
    PRE_IO BUT1_ibuf_preio (
            .PADOEN(N__2557),
            .PADOUT(N__2556),
            .PADIN(N__2555),
            .CLOCKENABLE(),
            .DOUT1(),
            .OUTPUTENABLE(),
            .DIN0(BUT1_c),
            .DOUT0(),
            .INPUTCLK(),
            .LATCHINPUTVALUE(),
            .DIN1(),
            .OUTPUTCLK());
    IO_PAD LED1_obuf_iopad (
            .OE(N__2548),
            .DIN(N__2547),
            .DOUT(N__2546),
            .PACKAGEPIN(LED1));
    defparam LED1_obuf_preio.NEG_TRIGGER=1'b0;
    defparam LED1_obuf_preio.PIN_TYPE=6'b011001;
    PRE_IO LED1_obuf_preio (
            .PADOEN(N__2548),
            .PADOUT(N__2547),
            .PADIN(N__2546),
            .CLOCKENABLE(),
            .DOUT1(),
            .OUTPUTENABLE(),
            .DIN0(),
            .DOUT0(N__1890),
            .INPUTCLK(),
            .LATCHINPUTVALUE(),
            .DIN1(),
            .OUTPUTCLK());
    IO_PAD LED2_obuf_iopad (
            .OE(N__2539),
            .DIN(N__2538),
            .DOUT(N__2537),
            .PACKAGEPIN(LED2));
    defparam LED2_obuf_preio.NEG_TRIGGER=1'b0;
    defparam LED2_obuf_preio.PIN_TYPE=6'b011001;
    PRE_IO LED2_obuf_preio (
            .PADOEN(N__2539),
            .PADOUT(N__2538),
            .PADIN(N__2537),
            .CLOCKENABLE(),
            .DOUT1(),
            .OUTPUTENABLE(),
            .DIN0(),
            .DOUT0(N__1944),
            .INPUTCLK(),
            .LATCHINPUTVALUE(),
            .DIN1(),
            .OUTPUTCLK());
    CascadeMux I__550 (
            .O(N__2520),
            .I(N__2516));
    InMux I__549 (
            .O(N__2519),
            .I(N__2513));
    InMux I__548 (
            .O(N__2516),
            .I(N__2510));
    LocalMux I__547 (
            .O(N__2513),
            .I(clk_divZ0Z_5));
    LocalMux I__546 (
            .O(N__2510),
            .I(clk_divZ0Z_5));
    InMux I__545 (
            .O(N__2505),
            .I(clk_div_1_cry_4));
    CascadeMux I__544 (
            .O(N__2502),
            .I(N__2498));
    InMux I__543 (
            .O(N__2501),
            .I(N__2495));
    InMux I__542 (
            .O(N__2498),
            .I(N__2492));
    LocalMux I__541 (
            .O(N__2495),
            .I(clk_divZ0Z_6));
    LocalMux I__540 (
            .O(N__2492),
            .I(clk_divZ0Z_6));
    InMux I__539 (
            .O(N__2487),
            .I(clk_div_1_cry_5));
    CascadeMux I__538 (
            .O(N__2484),
            .I(N__2480));
    InMux I__537 (
            .O(N__2483),
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
            .I(N__1212));
    LocalMux I__114 (
            .O(N__1212),
            .I(cntr_1_5));
    InMux I__113 (
            .O(N__1209),
            .I(cntr_1_cry_4));
    InMux I__112 (
            .O(N__1206),
            .I(N__1203));
    LocalMux I__111 (
            .O(N__1203),
            .I(cntr_1_6));
    InMux I__110 (
            .O(N__1200),
            .I(cntr_1_cry_5));
    InMux I__109 (
            .O(N__1197),
            .I(cntr_1_cry_6));
    InMux I__108 (
            .O(N__1194),
            .I(N__1191));
    LocalMux I__107 (
            .O(N__1191),
            .I(cntr_1_8));
    InMux I__106 (
            .O(N__1188),
            .I(cntr_1_cry_7));
    defparam IN_MUX_bfv_1_4_0_.C_INIT=2'b00;
    ICE_CARRY_IN_MUX IN_MUX_bfv_1_4_0_ (
            .carryinitin(),
            .carryinitout(bfn_1_4_0_));
    defparam IN_MUX_bfv_1_5_0_.C_INIT=2'b10;
    ICE_CARRY_IN_MUX IN_MUX_bfv_1_5_0_ (
            .carryinitin(cntr_1_cry_8),
            .carryinitout(bfn_1_5_0_));
    defparam IN_MUX_bfv_4_7_0_.C_INIT=2'b00;
    ICE_CARRY_IN_MUX IN_MUX_bfv_4_7_0_ (
            .carryinitin(),
            .carryinitout(bfn_4_7_0_));
    defparam IN_MUX_bfv_4_8_0_.C_INIT=2'b10;
    ICE_CARRY_IN_MUX IN_MUX_bfv_4_8_0_ (
            .carryinitin(clk_div_2_cry_8),
            .carryinitout(bfn_4_8_0_));
    defparam IN_MUX_bfv_5_7_0_.C_INIT=2'b00;
    ICE_CARRY_IN_MUX IN_MUX_bfv_5_7_0_ (
            .carryinitin(),
            .carryinitout(bfn_5_7_0_));
    defparam IN_MUX_bfv_5_8_0_.C_INIT=2'b10;
    ICE_CARRY_IN_MUX IN_MUX_bfv_5_8_0_ (
            .carryinitin(clk_div_1_cry_8),
            .carryinitout(bfn_5_8_0_));
    defparam IN_MUX_bfv_2_7_0_.C_INIT=2'b00;
    ICE_CARRY_IN_MUX IN_MUX_bfv_2_7_0_ (
            .carryinitin(),
            .carryinitout(bfn_2_7_0_));
    defparam IN_MUX_bfv_2_8_0_.C_INIT=2'b10;
    ICE_CARRY_IN_MUX IN_MUX_bfv_2_8_0_ (
            .carryinitin(un1_rst_cnt_1_cry_7),
            .carryinitout(bfn_2_8_0_));
    defparam IN_MUX_bfv_2_9_0_.C_INIT=2'b10;
    ICE_CARRY_IN_MUX IN_MUX_bfv_2_9_0_ (
            .carryinitin(un1_rst_cnt_1_cry_13_THRU_CRY_1_THRU_CO),
            .carryinitout(bfn_2_9_0_));
    VCC VCC (
            .Y(VCCG0));
    GND GND (
            .Y(GNDG0));
    ICE_GB clk_div_RNIM1KP1_0_11 (
            .USERSIGNALTOGLOBALBUFFER(N__1230),
            .GLOBALBUFFEROUTPUT(N_16_g));
    GND GND_Inst (
            .Y(_gnd_net_));
    defparam cntr_5_LC_1_3_3.C_ON=1'b0;
    defparam cntr_5_LC_1_3_3.SEQ_MODE=4'b1000;
    defparam cntr_5_LC_1_3_3.LUT_INIT=16'b0000110001001100;
    LogicCell40 cntr_5_LC_1_3_3 (
            .in0(N__1743),
            .in1(N__1215),
            .in2(N__1676),
            .in3(N__1609),
            .lcout(cntrZ0Z_5),
            .ltout(),
            .carryin(_gnd_net_),
            .carryout(),
            .clk(N__2377),
            .ce(N__2269),
            .sr(_gnd_net_));
    defparam cntr_6_LC_1_3_6.C_ON=1'b0;
    defparam cntr_6_LC_1_3_6.SEQ_MODE=4'b1000;
    defparam cntr_6_LC_1_3_6.LUT_INIT=16'b0011011100000000;
    LogicCell40 cntr_6_LC_1_3_6 (
            .in0(N__1608),
            .in1(N__1671),
            .in2(N__1749),
            .in3(N__1206),
            .lcout(cntrZ0Z_6),
            .ltout(),
            .carryin(_gnd_net_),
            .carryout(),
            .clk(N__2377),
            .ce(N__2269),
            .sr(_gnd_net_));
    defparam cntr_8_LC_1_3_7.C_ON=1'b0;
    defparam cntr_8_LC_1_3_7.SEQ_MODE=4'b1000;
    defparam cntr_8_LC_1_3_7.LUT_INIT=16'b0000110001001100;
    LogicCell40 cntr_8_LC_1_3_7 (
            .in0(N__1744),
            .in1(N__1194),
            .in2(N__1677),
            .in3(N__1610),
            .lcout(cntrZ0Z_8),
            .ltout(),
            .carryin(_gnd_net_),
            .carryout(),
            .clk(N__2377),
            .ce(N__2269),
            .sr(_gnd_net_));
    defparam cntr_1_cry_1_c_LC_1_4_0.C_ON=1'b1;
    defparam cntr_1_cry_1_c_LC_1_4_0.SEQ_MODE=4'b0000;
    defparam cntr_1_cry_1_c_LC_1_4_0.LUT_INIT=16'b0000000000000000;
    LogicCell40 cntr_1_cry_1_c_LC_1_4_0 (
            .in0(_gnd_net_),
            .in1(N__1312),
            .in2(N__1293),
            .in3(_gnd_net_),
            .lcout(),
            .ltout(),
            .carryin(bfn_1_4_0_),
            .carryout(cntr_1_cry_1),
            .clk(_gnd_net_),
            .ce(),
            .sr(_gnd_net_));
    defparam cntr_2_LC_1_4_1.C_ON=1'b1;
    defparam cntr_2_LC_1_4_1.SEQ_MODE=4'b1000;
    defparam cntr_2_LC_1_4_1.LUT_INIT=16'b1001100101100110;
    LogicCell40 cntr_2_LC_1_4_1 (
            .in0(_gnd_net_),
            .in1(N__1460),
            .in2(_gnd_net_),
            .in3(N__1224),
            .lcout(cntrZ0Z_2),
            .ltout(),
            .carryin(cntr_1_cry_1),
            .carryout(cntr_1_cry_2),
            .clk(N__2375),
            .ce(N__2267),
            .sr(_gnd_net_));
    defparam cntr_3_LC_1_4_2.C_ON=1'b1;
    defparam cntr_3_LC_1_4_2.SEQ_MODE=4'b1000;
    defparam cntr_3_LC_1_4_2.LUT_INIT=16'b1001100101100110;
    LogicCell40 cntr_3_LC_1_4_2 (
            .in0(_gnd_net_),
            .in1(N__1445),
            .in2(_gnd_net_),
            .in3(N__1221),
            .lcout(cntrZ0Z_3),
            .ltout(),
            .carryin(cntr_1_cry_2),
            .carryout(cntr_1_cry_3),
            .clk(N__2375),
            .ce(N__2267),
            .sr(_gnd_net_));
    defparam cntr_4_LC_1_4_3.C_ON=1'b1;
    defparam cntr_4_LC_1_4_3.SEQ_MODE=4'b1000;
    defparam cntr_4_LC_1_4_3.LUT_INIT=16'b1001100101100110;
    LogicCell40 cntr_4_LC_1_4_3 (
            .in0(_gnd_net_),
            .in1(N__1356),
            .in2(_gnd_net_),
            .in3(N__1218),
            .lcout(cntrZ0Z_4),
            .ltout(),
            .carryin(cntr_1_cry_3),
            .carryout(cntr_1_cry_4),
            .clk(N__2375),
            .ce(N__2267),
            .sr(_gnd_net_));
    defparam cntr_RNO_0_5_LC_1_4_4.C_ON=1'b1;
    defparam cntr_RNO_0_5_LC_1_4_4.SEQ_MODE=4'b0000;
    defparam cntr_RNO_0_5_LC_1_4_4.LUT_INIT=16'b1001100101100110;
    LogicCell40 cntr_RNO_0_5_LC_1_4_4 (
            .in0(_gnd_net_),
            .in1(N__1403),
            .in2(_gnd_net_),
            .in3(N__1209),
            .lcout(cntr_1_5),
            .ltout(),
            .carryin(cntr_1_cry_4),
            .carryout(cntr_1_cry_5),
            .clk(_gnd_net_),
            .ce(),
            .sr(_gnd_net_));
    defparam cntr_RNO_0_6_LC_1_4_5.C_ON=1'b1;
    defparam cntr_RNO_0_6_LC_1_4_5.SEQ_MODE=4'b0000;
    defparam cntr_RNO_0_6_LC_1_4_5.LUT_INIT=16'b1001100101100110;
    LogicCell40 cntr_RNO_0_6_LC_1_4_5 (
            .in0(_gnd_net_),
            .in1(N__1419),
            .in2(_gnd_net_),
            .in3(N__1200),
            .lcout(cntr_1_6),
            .ltout(),
            .carryin(cntr_1_cry_5),
            .carryout(cntr_1_cry_6),
            .clk(_gnd_net_),
            .ce(),
            .sr(_gnd_net_));
    defparam cntr_7_LC_1_4_6.C_ON=1'b1;
    defparam cntr_7_LC_1_4_6.SEQ_MODE=4'b1000;
    defparam cntr_7_LC_1_4_6.LUT_INIT=16'b1001100101100110;
    LogicCell40 cntr_7_LC_1_4_6 (
            .in0(_gnd_net_),
            .in1(N__1377),
            .in2(_gnd_net_),
            .in3(N__1197),
            .lcout(cntrZ0Z_7),
            .ltout(),
            .carryin(cntr_1_cry_6),
            .carryout(cntr_1_cry_7),
            .clk(N__2375),
            .ce(N__2267),
            .sr(_gnd_net_));
    defparam cntr_RNO_0_8_LC_1_4_7.C_ON=1'b1;
    defparam cntr_RNO_0_8_LC_1_4_7.SEQ_MODE=4'b0000;
    defparam cntr_RNO_0_8_LC_1_4_7.LUT_INIT=16'b1001100101100110;
    LogicCell40 cntr_RNO_0_8_LC_1_4_7 (
            .in0(_gnd_net_),
            .in1(N__1497),
            .in2(_gnd_net_),
            .in3(N__1188),
            .lcout(cntr_1_8),
            .ltout(),
            .carryin(cntr_1_cry_7),
            .carryout(cntr_1_cry_8),
            .clk(_gnd_net_),
            .ce(),
            .sr(_gnd_net_));
    defparam cntr_RNO_0_9_LC_1_5_0.C_ON=1'b1;
    defparam cntr_RNO_0_9_LC_1_5_0.SEQ_MODE=4'b0000;
    defparam cntr_RNO_0_9_LC_1_5_0.LUT_INIT=16'b1001100101100110;
    LogicCell40 cntr_RNO_0_9_LC_1_5_0 (
            .in0(_gnd_net_),
            .in1(N__1789),
            .in2(_gnd_net_),
            .in3(N__1248),
            .lcout(cntr_1_9),
            .ltout(),
            .carryin(bfn_1_5_0_),
            .carryout(cntr_1_cry_9),
            .clk(_gnd_net_),
            .ce(),
            .sr(_gnd_net_));
    defparam cntr_RNO_0_10_LC_1_5_1.C_ON=1'b1;
    defparam cntr_RNO_0_10_LC_1_5_1.SEQ_MODE=4'b0000;
    defparam cntr_RNO_0_10_LC_1_5_1.LUT_INIT=16'b1001100101100110;
    LogicCell40 cntr_RNO_0_10_LC_1_5_1 (
            .in0(_gnd_net_),
            .in1(N__1329),
            .in2(_gnd_net_),
            .in3(N__1245),
            .lcout(cntr_1_10),
            .ltout(),
            .carryin(cntr_1_cry_9),
            .carryout(cntr_1_cry_10),
            .clk(_gnd_net_),
            .ce(),
            .sr(_gnd_net_));
    defparam cntr_RNO_0_11_LC_1_5_2.C_ON=1'b1;
    defparam cntr_RNO_0_11_LC_1_5_2.SEQ_MODE=4'b0000;
    defparam cntr_RNO_0_11_LC_1_5_2.LUT_INIT=16'b1001100101100110;
    LogicCell40 cntr_RNO_0_11_LC_1_5_2 (
            .in0(_gnd_net_),
            .in1(N__1767),
            .in2(_gnd_net_),
            .in3(N__1242),
            .lcout(cntr_1_11),
            .ltout(),
            .carryin(cntr_1_cry_10),
            .carryout(cntr_1_cry_11),
            .clk(_gnd_net_),
            .ce(),
            .sr(_gnd_net_));
    defparam cntr_RNO_0_12_LC_1_5_3.C_ON=1'b1;
    defparam cntr_RNO_0_12_LC_1_5_3.SEQ_MODE=4'b0000;
    defparam cntr_RNO_0_12_LC_1_5_3.LUT_INIT=16'b1001100101100110;
    LogicCell40 cntr_RNO_0_12_LC_1_5_3 (
            .in0(_gnd_net_),
            .in1(N__1572),
            .in2(_gnd_net_),
            .in3(N__1239),
            .lcout(cntr_1_12),
            .ltout(),
            .carryin(cntr_1_cry_11),
            .carryout(cntr_1_cry_12),
            .clk(_gnd_net_),
            .ce(),
            .sr(_gnd_net_));
    defparam cntr_13_LC_1_5_4.C_ON=1'b1;
    defparam cntr_13_LC_1_5_4.SEQ_MODE=4'b1000;
    defparam cntr_13_LC_1_5_4.LUT_INIT=16'b1001100101100110;
    LogicCell40 cntr_13_LC_1_5_4 (
            .in0(_gnd_net_),
            .in1(N__1733),
            .in2(_gnd_net_),
            .in3(N__1236),
            .lcout(cntrZ0Z_13),
            .ltout(),
            .carryin(cntr_1_cry_12),
            .carryout(cntr_1_cry_13),
            .clk(N__2373),
            .ce(N__2266),
            .sr(_gnd_net_));
    defparam cntr_14_LC_1_5_5.C_ON=1'b0;
    defparam cntr_14_LC_1_5_5.SEQ_MODE=4'b1000;
    defparam cntr_14_LC_1_5_5.LUT_INIT=16'b0011001100000100;
    LogicCell40 cntr_14_LC_1_5_5 (
            .in0(N__1734),
            .in1(N__1641),
            .in2(N__1614),
            .in3(N__1233),
            .lcout(cntrZ0Z_14),
            .ltout(),
            .carryin(_gnd_net_),
            .carryout(),
            .clk(N__2373),
            .ce(N__2266),
            .sr(_gnd_net_));
    defparam mode_LC_1_7_3.C_ON=1'b0;
    defparam mode_LC_1_7_3.SEQ_MODE=4'b1000;
    defparam mode_LC_1_7_3.LUT_INIT=16'b0011001111001100;
    LogicCell40 mode_LC_1_7_3 (
            .in0(_gnd_net_),
            .in1(N__1916),
            .in2(_gnd_net_),
            .in3(N__1980),
            .lcout(modeZ0),
            .ltout(),
            .carryin(_gnd_net_),
            .carryout(),
            .clk(N__2369),
            .ce(),
            .sr(_gnd_net_));
    defparam CONSTANT_ONE_LUT4_LC_1_8_0.C_ON=1'b0;
    defparam CONSTANT_ONE_LUT4_LC_1_8_0.SEQ_MODE=4'b0000;
    defparam CONSTANT_ONE_LUT4_LC_1_8_0.LUT_INIT=16'b1111111111111111;
    LogicCell40 CONSTANT_ONE_LUT4_LC_1_8_0 (
            .in0(_gnd_net_),
            .in1(_gnd_net_),
            .in2(_gnd_net_),
            .in3(_gnd_net_),
            .lcout(CONSTANT_ONE_NET),
            .ltout(),
            .carryin(_gnd_net_),
            .carryout(),
            .clk(_gnd_net_),
            .ce(),
            .sr(_gnd_net_));
    defparam clk_div_RNIM1KP1_11_LC_1_8_2.C_ON=1'b0;
    defparam clk_div_RNIM1KP1_11_LC_1_8_2.SEQ_MODE=4'b0000;
    defparam clk_div_RNIM1KP1_11_LC_1_8_2.LUT_INIT=16'b0000000011110000;
    LogicCell40 clk_div_RNIM1KP1_11_LC_1_8_2 (
            .in0(_gnd_net_),
            .in1(_gnd_net_),
            .in2(N__2214),
            .in3(N__2196),
            .lcout(clk_div_RNIM1KP1Z0Z_11),
            .ltout(),
            .carryin(_gnd_net_),
            .carryout(),
            .clk(_gnd_net_),
            .ce(),
            .sr(_gnd_net_));
    defparam rst_cnt_esr_RNI37G6_14_LC_1_8_3.C_ON=1'b0;
    defparam rst_cnt_esr_RNI37G6_14_LC_1_8_3.SEQ_MODE=4'b0000;
    defparam rst_cnt_esr_RNI37G6_14_LC_1_8_3.LUT_INIT=16'b0000000011111111;
    LogicCell40 rst_cnt_esr_RNI37G6_14_LC_1_8_3 (
            .in0(_gnd_net_),
            .in1(_gnd_net_),
            .in2(_gnd_net_),
            .in3(N__2008),
            .lcout(rst_cnt_i_14),
            .ltout(),
            .carryin(_gnd_net_),
            .carryout(),
            .clk(_gnd_net_),
            .ce(),
            .sr(_gnd_net_));
    defparam BUT1_r_RNIKV9M2_LC_1_8_5.C_ON=1'b0;
    defparam BUT1_r_RNIKV9M2_LC_1_8_5.SEQ_MODE=4'b0000;
    defparam BUT1_r_RNIKV9M2_LC_1_8_5.LUT_INIT=16'b0000010000000000;
    LogicCell40 BUT1_r_RNIKV9M2_LC_1_8_5 (
            .in0(N__2403),
            .in1(N__2009),
            .in2(N__2154),
            .in3(N__2314),
            .lcout(BUT1_r_RNIKV9MZ0Z2),
            .ltout(BUT1_r_RNIKV9MZ0Z2_cascade_),
            .carryin(_gnd_net_),
            .carryout(),
            .clk(_gnd_net_),
            .ce(),
            .sr(_gnd_net_));
    defparam rst_cnt_esr_RNO_0_14_LC_1_8_6.C_ON=1'b0;
    defparam rst_cnt_esr_RNO_0_14_LC_1_8_6.SEQ_MODE=4'b0000;
    defparam rst_cnt_esr_RNO_0_14_LC_1_8_6.LUT_INIT=16'b1111101011111010;
    LogicCell40 rst_cnt_esr_RNO_0_14_LC_1_8_6 (
            .in0(N__2315),
            .in1(_gnd_net_),
            .in2(N__1272),
            .in3(_gnd_net_),
            .lcout(N_16_0),
            .ltout(),
            .carryin(_gnd_net_),
            .carryout(),
            .clk(_gnd_net_),
            .ce(),
            .sr(_gnd_net_));
    defparam LED1_m1_r_LC_2_2_3.C_ON=1'b0;
    defparam LED1_m1_r_LC_2_2_3.SEQ_MODE=4'b1001;
    defparam LED1_m1_r_LC_2_2_3.LUT_INIT=16'b0000000011001100;
    LogicCell40 LED1_m1_r_LC_2_2_3 (
            .in0(_gnd_net_),
            .in1(N__1901),
            .in2(_gnd_net_),
            .in3(N__1256),
            .lcout(LED1_m1_rZ0),
            .ltout(),
            .carryin(_gnd_net_),
            .carryout(),
            .clk(N__2380),
            .ce(),
            .sr(N__1269));
    defparam LED2_m1_r_LC_2_2_5.C_ON=1'b0;
    defparam LED2_m1_r_LC_2_2_5.SEQ_MODE=4'b1000;
    defparam LED2_m1_r_LC_2_2_5.LUT_INIT=16'b1111111110101010;
    LogicCell40 LED2_m1_r_LC_2_2_5 (
            .in0(N__1955),
            .in1(_gnd_net_),
            .in2(_gnd_net_),
            .in3(N__1257),
            .lcout(LED2_m1_rZ0),
            .ltout(),
            .carryin(_gnd_net_),
            .carryout(),
            .clk(N__2380),
            .ce(),
            .sr(N__1269));
    defparam cntr_RNITQ4V2_14_LC_2_3_1.C_ON=1'b0;
    defparam cntr_RNITQ4V2_14_LC_2_3_1.SEQ_MODE=4'b0000;
    defparam cntr_RNITQ4V2_14_LC_2_3_1.LUT_INIT=16'b1110000000000000;
    LogicCell40 cntr_RNITQ4V2_14_LC_2_3_1 (
            .in0(N__1742),
            .in1(N__1603),
            .in2(N__1675),
            .in3(N__2316),
            .lcout(cntr_RNITQ4V2Z0Z_14),
            .ltout(),
            .carryin(_gnd_net_),
            .carryout(),
            .clk(_gnd_net_),
            .ce(),
            .sr(_gnd_net_));
    defparam cntr_RNIGH28_5_LC_2_3_4.C_ON=1'b0;
    defparam cntr_RNIGH28_5_LC_2_3_4.SEQ_MODE=4'b0000;
    defparam cntr_RNIGH28_5_LC_2_3_4.LUT_INIT=16'b1000100000000000;
    LogicCell40 cntr_RNIGH28_5_LC_2_3_4 (
            .in0(N__1482),
            .in1(N__1378),
            .in2(_gnd_net_),
            .in3(N__1404),
            .lcout(),
            .ltout(LED1_m1_r_cnv_7_cascade_),
            .carryin(_gnd_net_),
            .carryout(),
            .clk(_gnd_net_),
            .ce(),
            .sr(_gnd_net_));
    defparam cntr_RNIV9NN2_4_LC_2_3_5.C_ON=1'b0;
    defparam cntr_RNIV9NN2_4_LC_2_3_5.SEQ_MODE=4'b0000;
    defparam cntr_RNIV9NN2_4_LC_2_3_5.LUT_INIT=16'b1000000000000000;
    LogicCell40 cntr_RNIV9NN2_4_LC_2_3_5 (
            .in0(N__1476),
            .in1(N__1431),
            .in2(N__1260),
            .in3(N__2317),
            .lcout(cntr_RNIV9NN2Z0Z_4),
            .ltout(),
            .carryin(_gnd_net_),
            .carryout(),
            .clk(_gnd_net_),
            .ce(),
            .sr(_gnd_net_));
    defparam cntr_RNIKC8M_8_LC_2_4_0.C_ON=1'b0;
    defparam cntr_RNIKC8M_8_LC_2_4_0.SEQ_MODE=4'b0000;
    defparam cntr_RNIKC8M_8_LC_2_4_0.LUT_INIT=16'b1000000000000000;
    LogicCell40 cntr_RNIKC8M_8_LC_2_4_0 (
            .in0(N__1496),
            .in1(N__1341),
            .in2(N__1797),
            .in3(N__1467),
            .lcout(),
            .ltout(cntr7lto7_0_4_cascade_),
            .carryin(_gnd_net_),
            .carryout(),
            .clk(_gnd_net_),
            .ce(),
            .sr(_gnd_net_));
    defparam cntr_RNI0LHN_5_LC_2_4_1.C_ON=1'b0;
    defparam cntr_RNI0LHN_5_LC_2_4_1.SEQ_MODE=4'b0000;
    defparam cntr_RNI0LHN_5_LC_2_4_1.LUT_INIT=16'b1111000011100000;
    LogicCell40 cntr_RNI0LHN_5_LC_2_4_1 (
            .in0(N__1382),
            .in1(N__1430),
            .in2(N__1500),
            .in3(N__1402),
            .lcout(cntr7lt13),
            .ltout(),
            .carryin(_gnd_net_),
            .carryout(),
            .clk(_gnd_net_),
            .ce(),
            .sr(_gnd_net_));
    defparam cntr_RNI6JK7_6_LC_2_4_2.C_ON=1'b0;
    defparam cntr_RNI6JK7_6_LC_2_4_2.SEQ_MODE=4'b0000;
    defparam cntr_RNI6JK7_6_LC_2_4_2.LUT_INIT=16'b0000000000100000;
    LogicCell40 cntr_RNI6JK7_6_LC_2_4_2 (
            .in0(N__1495),
            .in1(N__1418),
            .in2(N__1796),
            .in3(N__1571),
            .lcout(LED1_m1_r_cnv_5),
            .ltout(),
            .carryin(_gnd_net_),
            .carryout(),
            .clk(_gnd_net_),
            .ce(),
            .sr(_gnd_net_));
    defparam cntr_RNINC5L_4_LC_2_4_3.C_ON=1'b0;
    defparam cntr_RNINC5L_4_LC_2_4_3.SEQ_MODE=4'b0000;
    defparam cntr_RNINC5L_4_LC_2_4_3.LUT_INIT=16'b0010000000000000;
    LogicCell40 cntr_RNINC5L_4_LC_2_4_3 (
            .in0(N__1766),
            .in1(N__1355),
            .in2(N__1741),
            .in3(N__1328),
            .lcout(LED1_m1_r_cnv_6),
            .ltout(),
            .carryin(_gnd_net_),
            .carryout(),
            .clk(_gnd_net_),
            .ce(),
            .sr(_gnd_net_));
    defparam cntr_RNIJEUK_10_LC_2_4_5.C_ON=1'b0;
    defparam cntr_RNIJEUK_10_LC_2_4_5.SEQ_MODE=4'b0000;
    defparam cntr_RNIJEUK_10_LC_2_4_5.LUT_INIT=16'b1000100000000000;
    LogicCell40 cntr_RNIJEUK_10_LC_2_4_5 (
            .in0(N__1570),
            .in1(N__1765),
            .in2(_gnd_net_),
            .in3(N__1327),
            .lcout(cntr7lto7_0_2),
            .ltout(),
            .carryin(_gnd_net_),
            .carryout(),
            .clk(_gnd_net_),
            .ce(),
            .sr(_gnd_net_));
    defparam cntr_RNI2AR_1_LC_2_4_6.C_ON=1'b0;
    defparam cntr_RNI2AR_1_LC_2_4_6.SEQ_MODE=4'b0000;
    defparam cntr_RNI2AR_1_LC_2_4_6.LUT_INIT=16'b1000000000000000;
    LogicCell40 cntr_RNI2AR_1_LC_2_4_6 (
            .in0(N__1461),
            .in1(N__1288),
            .in2(N__1446),
            .in3(N__1311),
            .lcout(cntr7lt5_3),
            .ltout(),
            .carryin(_gnd_net_),
            .carryout(),
            .clk(_gnd_net_),
            .ce(),
            .sr(_gnd_net_));
    defparam cntr_RNIIQR_4_LC_2_4_7.C_ON=1'b0;
    defparam cntr_RNIIQR_4_LC_2_4_7.SEQ_MODE=4'b0000;
    defparam cntr_RNIIQR_4_LC_2_4_7.LUT_INIT=16'b1111101011111000;
    LogicCell40 cntr_RNIIQR_4_LC_2_4_7 (
            .in0(N__1417),
            .in1(N__1401),
            .in2(N__1383),
            .in3(N__1354),
            .lcout(cntr7lto7_c),
            .ltout(),
            .carryin(_gnd_net_),
            .carryout(),
            .clk(_gnd_net_),
            .ce(),
            .sr(_gnd_net_));
    defparam cntr_0_LC_2_5_0.C_ON=1'b0;
    defparam cntr_0_LC_2_5_0.SEQ_MODE=4'b1000;
    defparam cntr_0_LC_2_5_0.LUT_INIT=16'b0000000011111111;
    LogicCell40 cntr_0_LC_2_5_0 (
            .in0(_gnd_net_),
            .in1(_gnd_net_),
            .in2(_gnd_net_),
            .in3(N__1313),
            .lcout(cntrZ0Z_0),
            .ltout(),
            .carryin(_gnd_net_),
            .carryout(),
            .clk(N__2376),
            .ce(N__2268),
            .sr(_gnd_net_));
    defparam cntr_10_LC_2_5_1.C_ON=1'b0;
    defparam cntr_10_LC_2_5_1.SEQ_MODE=4'b1000;
    defparam cntr_10_LC_2_5_1.LUT_INIT=16'b0000101000101010;
    LogicCell40 cntr_10_LC_2_5_1 (
            .in0(N__1335),
            .in1(N__1737),
            .in2(N__1662),
            .in3(N__1605),
            .lcout(cntrZ0Z_10),
            .ltout(),
            .carryin(_gnd_net_),
            .carryout(),
            .clk(N__2376),
            .ce(N__2268),
            .sr(_gnd_net_));
    defparam cntr_1_LC_2_5_2.C_ON=1'b0;
    defparam cntr_1_LC_2_5_2.SEQ_MODE=4'b1000;
    defparam cntr_1_LC_2_5_2.LUT_INIT=16'b1100001100111100;
    LogicCell40 cntr_1_LC_2_5_2 (
            .in0(_gnd_net_),
            .in1(N__1292),
            .in2(_gnd_net_),
            .in3(N__1314),
            .lcout(cntrZ0Z_1),
            .ltout(),
            .carryin(_gnd_net_),
            .carryout(),
            .clk(N__2376),
            .ce(N__2268),
            .sr(_gnd_net_));
    defparam cntr_9_LC_2_5_3.C_ON=1'b0;
    defparam cntr_9_LC_2_5_3.SEQ_MODE=4'b1000;
    defparam cntr_9_LC_2_5_3.LUT_INIT=16'b0000110001001100;
    LogicCell40 cntr_9_LC_2_5_3 (
            .in0(N__1736),
            .in1(N__1803),
            .in2(N__1664),
            .in3(N__1607),
            .lcout(cntrZ0Z_9),
            .ltout(),
            .carryin(_gnd_net_),
            .carryout(),
            .clk(N__2376),
            .ce(N__2268),
            .sr(_gnd_net_));
    defparam cntr_11_LC_2_5_6.C_ON=1'b0;
    defparam cntr_11_LC_2_5_6.SEQ_MODE=4'b1000;
    defparam cntr_11_LC_2_5_6.LUT_INIT=16'b0011011100000000;
    LogicCell40 cntr_11_LC_2_5_6 (
            .in0(N__1604),
            .in1(N__1645),
            .in2(N__1748),
            .in3(N__1773),
            .lcout(cntrZ0Z_11),
            .ltout(),
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
            .ltout(),
            .carryin(un1_rst_cnt_1_cry_11),
            .carryout(un1_rst_cnt_1_cry_12),
            .clk(N__2368),
            .ce(),
            .sr(N__1981));
    defparam rst_cnt_13_LC_2_8_5.C_ON=1'b1;
    defparam rst_cnt_13_LC_2_8_5.SEQ_MODE=4'b1000;
    defparam rst_cnt_13_LC_2_8_5.LUT_INIT=16'b0110011011001100;
    LogicCell40 rst_cnt_13_LC_2_8_5 (
            .in0(N__2319),
            .in1(N__2034),
            .in2(_gnd_net_),
            .in3(N__2028),
            .lcout(rst_cntZ0Z_13),
            .ltout(),
            .carryin(un1_rst_cnt_1_cry_12),
            .carryout(un1_rst_cnt_1_cry_13),
            .clk(N__2368),
            .ce(),
            .sr(N__1981));
    defparam un1_rst_cnt_1_cry_13_c_THRU_CRY_0_LC_2_8_6.C_ON=1'b1;
    defparam un1_rst_cnt_1_cry_13_c_THRU_CRY_0_LC_2_8_6.SEQ_MODE=4'b0000;
    defparam un1_rst_cnt_1_cry_13_c_THRU_CRY_0_LC_2_8_6.LUT_INIT=16'b0000000000000000;
    LogicCell40 un1_rst_cnt_1_cry_13_c_THRU_CRY_0_LC_2_8_6 (
            .in0(_gnd_net_),
            .in1(N__2024),
            .in2(GNDG0),
            .in3(_gnd_net_),
            .lcout(),
            .ltout(),
            .carryin(un1_rst_cnt_1_cry_13),
            .carryout(un1_rst_cnt_1_cry_13_THRU_CRY_0_THRU_CO),
            .clk(_gnd_net_),
            .ce(),
            .sr(_gnd_net_));
    defparam un1_rst_cnt_1_cry_13_c_THRU_CRY_1_LC_2_8_7.C_ON=1'b1;
    defparam un1_rst_cnt_1_cry_13_c_THRU_CRY_1_LC_2_8_7.SEQ_MODE=4'b0000;
    defparam un1_rst_cnt_1_cry_13_c_THRU_CRY_1_LC_2_8_7.LUT_INIT=16'b0000000000000000;
    LogicCell40 un1_rst_cnt_1_cry_13_c_THRU_CRY_1_LC_2_8_7 (
            .in0(_gnd_net_),
            .in1(N__2025),
            .in2(GNDG0),
            .in3(_gnd_net_),
            .lcout(),
            .ltout(),
            .carryin(un1_rst_cnt_1_cry_13_THRU_CRY_0_THRU_CO),
            .carryout(un1_rst_cnt_1_cry_13_THRU_CRY_1_THRU_CO),
            .clk(_gnd_net_),
            .ce(),
            .sr(_gnd_net_));
    defparam rst_cnt_esr_14_LC_2_9_0.C_ON=1'b0;
    defparam rst_cnt_esr_14_LC_2_9_0.SEQ_MODE=4'b1000;
    defparam rst_cnt_esr_14_LC_2_9_0.LUT_INIT=16'b0011001111001100;
    LogicCell40 rst_cnt_esr_14_LC_2_9_0 (
            .in0(_gnd_net_),
            .in1(N__2010),
            .in2(_gnd_net_),
            .in3(N__2013),
            .lcout(rst_cntZ0Z_14),
            .ltout(),
            .carryin(_gnd_net_),
            .carryout(),
            .clk(N__2371),
            .ce(N__1995),
            .sr(N__1983));
    defparam LED2_obuf_RNO_LC_4_2_3.C_ON=1'b0;
    defparam LED2_obuf_RNO_LC_4_2_3.SEQ_MODE=4'b0000;
    defparam LED2_obuf_RNO_LC_4_2_3.LUT_INIT=16'b1011101110001000;
    LogicCell40 LED2_obuf_RNO_LC_4_2_3 (
            .in0(N__2175),
            .in1(N__1929),
            .in2(_gnd_net_),
            .in3(N__1959),
            .lcout(LED2_c),
            .ltout(),
            .carryin(_gnd_net_),
            .carryout(),
            .clk(_gnd_net_),
            .ce(),
            .sr(_gnd_net_));
    defparam LED1_obuf_RNO_LC_4_2_4.C_ON=1'b0;
    defparam LED1_obuf_RNO_LC_4_2_4.SEQ_MODE=4'b0000;
    defparam LED1_obuf_RNO_LC_4_2_4.LUT_INIT=16'b1101110110001000;
    LogicCell40 LED1_obuf_RNO_LC_4_2_4 (
            .in0(N__1928),
            .in1(N__2181),
            .in2(_gnd_net_),
            .in3(N__1905),
            .lcout(LED1_c),
            .ltout(),
            .carryin(_gnd_net_),
            .carryout(),
            .clk(_gnd_net_),
            .ce(),
            .sr(_gnd_net_));
    defparam clk_div_1_LC_4_6_0.C_ON=1'b0;
    defparam clk_div_1_LC_4_6_0.SEQ_MODE=4'b1000;
    defparam clk_div_1_LC_4_6_0.LUT_INIT=16'b1010010101011010;
    LogicCell40 clk_div_1_LC_4_6_0 (
            .in0(N__2113),
            .in1(_gnd_net_),
            .in2(_gnd_net_),
            .in3(N__2133),
            .lcout(clk_divZ0Z_1),
            .ltout(),
            .carryin(_gnd_net_),
            .carryout(),
            .clk(N__2378),
            .ce(),
            .sr(_gnd_net_));
    defparam clk_div_0_LC_4_6_1.C_ON=1'b0;
    defparam clk_div_0_LC_4_6_1.SEQ_MODE=4'b1000;
    defparam clk_div_0_LC_4_6_1.LUT_INIT=16'b0000000011111111;
    LogicCell40 clk_div_0_LC_4_6_1 (
            .in0(_gnd_net_),
            .in1(_gnd_net_),
            .in2(_gnd_net_),
            .in3(N__2112),
            .lcout(clk_divZ0Z_0),
            .ltout(),
            .carryin(_gnd_net_),
            .carryout(),
            .clk(N__2378),
            .ce(),
            .sr(_gnd_net_));
    defparam clk_div_RNI91U1_1_LC_4_7_0.C_ON=1'b1;
    defparam clk_div_RNI91U1_1_LC_4_7_0.SEQ_MODE=4'b0000;
    defparam clk_div_RNI91U1_1_LC_4_7_0.LUT_INIT=16'b0000000000000000;
    LogicCell40 clk_div_RNI91U1_1_LC_4_7_0 (
            .in0(_gnd_net_),
            .in1(N__2131),
            .in2(N__2114),
            .in3(_gnd_net_),
            .lcout(),
            .ltout(),
            .carryin(bfn_4_7_0_),
            .carryout(clk_div_2_cry_1),
            .clk(_gnd_net_),
            .ce(),
            .sr(_gnd_net_));
    defparam clk_div_RNIF3T2_2_LC_4_7_1.C_ON=1'b1;
    defparam clk_div_RNIF3T2_2_LC_4_7_1.SEQ_MODE=4'b0000;
    defparam clk_div_RNIF3T2_2_LC_4_7_1.LUT_INIT=16'b0000000000000000;
    LogicCell40 clk_div_RNIF3T2_2_LC_4_7_1 (
            .in0(_gnd_net_),
            .in1(_gnd_net_),
            .in2(N__2088),
            .in3(_gnd_net_),
            .lcout(),
            .ltout(),
            .carryin(clk_div_2_cry_1),
            .carryout(clk_div_2_cry_2),
            .clk(_gnd_net_),
            .ce(),
            .sr(_gnd_net_));
    defparam clk_div_RNIM6S3_3_LC_4_7_2.C_ON=1'b1;
    defparam clk_div_RNIM6S3_3_LC_4_7_2.SEQ_MODE=4'b0000;
    defparam clk_div_RNIM6S3_3_LC_4_7_2.LUT_INIT=16'b0000000000000000;
    LogicCell40 clk_div_RNIM6S3_3_LC_4_7_2 (
            .in0(_gnd_net_),
            .in1(_gnd_net_),
            .in2(N__2070),
            .in3(_gnd_net_),
            .lcout(),
            .ltout(),
            .carryin(clk_div_2_cry_2),
            .carryout(clk_div_2_cry_3),
            .clk(_gnd_net_),
            .ce(),
            .sr(_gnd_net_));
    defparam clk_div_RNIUAR4_4_LC_4_7_3.C_ON=1'b1;
    defparam clk_div_RNIUAR4_4_LC_4_7_3.SEQ_MODE=4'b0000;
    defparam clk_div_RNIUAR4_4_LC_4_7_3.LUT_INIT=16'b0000000000000000;
    LogicCell40 clk_div_RNIUAR4_4_LC_4_7_3 (
            .in0(_gnd_net_),
            .in1(_gnd_net_),
            .in2(N__2052),
            .in3(_gnd_net_),
            .lcout(),
            .ltout(),
            .carryin(clk_div_2_cry_3),
            .carryout(clk_div_2_cry_4),
            .clk(_gnd_net_),
            .ce(),
            .sr(_gnd_net_));
    defparam clk_div_RNI7GQ5_5_LC_4_7_4.C_ON=1'b1;
    defparam clk_div_RNI7GQ5_5_LC_4_7_4.SEQ_MODE=4'b0000;
    defparam clk_div_RNI7GQ5_5_LC_4_7_4.LUT_INIT=16'b0000000000000000;
    LogicCell40 clk_div_RNI7GQ5_5_LC_4_7_4 (
            .in0(_gnd_net_),
            .in1(_gnd_net_),
            .in2(N__2520),
            .in3(_gnd_net_),
            .lcout(),
            .ltout(),
            .carryin(clk_div_2_cry_4),
            .carryout(clk_div_2_cry_5),
            .clk(_gnd_net_),
            .ce(),
            .sr(_gnd_net_));
    defparam clk_div_RNIHMP6_6_LC_4_7_5.C_ON=1'b1;
    defparam clk_div_RNIHMP6_6_LC_4_7_5.SEQ_MODE=4'b0000;
    defparam clk_div_RNIHMP6_6_LC_4_7_5.LUT_INIT=16'b0000000000000000;
    LogicCell40 clk_div_RNIHMP6_6_LC_4_7_5 (
            .in0(_gnd_net_),
            .in1(_gnd_net_),
            .in2(N__2502),
            .in3(_gnd_net_),
            .lcout(),
            .ltout(),
            .carryin(clk_div_2_cry_5),
            .carryout(clk_div_2_cry_6),
            .clk(_gnd_net_),
            .ce(),
            .sr(_gnd_net_));
    defparam clk_div_RNISTO7_7_LC_4_7_6.C_ON=1'b1;
    defparam clk_div_RNISTO7_7_LC_4_7_6.SEQ_MODE=4'b0000;
    defparam clk_div_RNISTO7_7_LC_4_7_6.LUT_INIT=16'b0000000000000000;
    LogicCell40 clk_div_RNISTO7_7_LC_4_7_6 (
            .in0(_gnd_net_),
            .in1(_gnd_net_),
            .in2(N__2484),
            .in3(_gnd_net_),
            .lcout(),
            .ltout(),
            .carryin(clk_div_2_cry_6),
            .carryout(clk_div_2_cry_7),
            .clk(_gnd_net_),
            .ce(),
            .sr(_gnd_net_));
    defparam clk_div_RNI86O8_8_LC_4_7_7.C_ON=1'b1;
    defparam clk_div_RNI86O8_8_LC_4_7_7.SEQ_MODE=4'b0000;
    defparam clk_div_RNI86O8_8_LC_4_7_7.LUT_INIT=16'b0000000000000000;
    LogicCell40 clk_div_RNI86O8_8_LC_4_7_7 (
            .in0(_gnd_net_),
            .in1(_gnd_net_),
            .in2(N__2466),
            .in3(_gnd_net_),
            .lcout(),
            .ltout(),
            .carryin(clk_div_2_cry_7),
            .carryout(clk_div_2_cry_8),
            .clk(_gnd_net_),
            .ce(),
            .sr(_gnd_net_));
    defparam clk_div_RNILFN9_9_LC_4_8_0.C_ON=1'b1;
    defparam clk_div_RNILFN9_9_LC_4_8_0.SEQ_MODE=4'b0000;
    defparam clk_div_RNILFN9_9_LC_4_8_0.LUT_INIT=16'b0000000000000000;
    LogicCell40 clk_div_RNILFN9_9_LC_4_8_0 (
            .in0(_gnd_net_),
            .in1(_gnd_net_),
            .in2(N__2448),
            .in3(_gnd_net_),
            .lcout(),
            .ltout(),
            .carryin(bfn_4_8_0_),
            .carryout(clk_div_2_cry_9),
            .clk(_gnd_net_),
            .ce(),
            .sr(_gnd_net_));
    defparam clk_div_RNIAAMP_10_LC_4_8_1.C_ON=1'b1;
    defparam clk_div_RNIAAMP_10_LC_4_8_1.SEQ_MODE=4'b0000;
    defparam clk_div_RNIAAMP_10_LC_4_8_1.LUT_INIT=16'b0000000000000000;
    LogicCell40 clk_div_RNIAAMP_10_LC_4_8_1 (
            .in0(_gnd_net_),
            .in1(N__2426),
            .in2(_gnd_net_),
            .in3(_gnd_net_),
            .lcout(),
            .ltout(),
            .carryin(clk_div_2_cry_9),
            .carryout(clk_div_2_cry_10),
            .clk(_gnd_net_),
            .ce(),
            .sr(_gnd_net_));
    defparam clk_div_RNI06L91_11_LC_4_8_2.C_ON=1'b0;
    defparam clk_div_RNI06L91_11_LC_4_8_2.SEQ_MODE=4'b0000;
    defparam clk_div_RNI06L91_11_LC_4_8_2.LUT_INIT=16'b0011001111001100;
    LogicCell40 clk_div_RNI06L91_11_LC_4_8_2 (
            .in0(_gnd_net_),
            .in1(N__2192),
            .in2(_gnd_net_),
            .in3(N__2217),
            .lcout(clk_div_RNI06L91Z0Z_11),
            .ltout(),
            .carryin(_gnd_net_),
            .carryout(),
            .clk(_gnd_net_),
            .ce(),
            .sr(_gnd_net_));
    defparam clk_div_11_LC_4_8_5.C_ON=1'b0;
    defparam clk_div_11_LC_4_8_5.SEQ_MODE=4'b1000;
    defparam clk_div_11_LC_4_8_5.LUT_INIT=16'b1111111100000000;
    LogicCell40 clk_div_11_LC_4_8_5 (
            .in0(_gnd_net_),
            .in1(_gnd_net_),
            .in2(_gnd_net_),
            .in3(N__2210),
            .lcout(clk_div_i_11),
            .ltout(),
            .carryin(_gnd_net_),
            .carryout(),
            .clk(N__2372),
            .ce(),
            .sr(_gnd_net_));
    defparam LED1_m0_r_LC_5_2_1.C_ON=1'b0;
    defparam LED1_m0_r_LC_5_2_1.SEQ_MODE=4'b1000;
    defparam LED1_m0_r_LC_5_2_1.LUT_INIT=16'b0000000011111111;
    LogicCell40 LED1_m0_r_LC_5_2_1 (
            .in0(_gnd_net_),
            .in1(_gnd_net_),
            .in2(_gnd_net_),
            .in3(N__2396),
            .lcout(LED1_m0_rZ0),
            .ltout(),
            .carryin(_gnd_net_),
            .carryout(),
            .clk(N__2381),
            .ce(N__2270),
            .sr(_gnd_net_));
    defparam LED2_m0_r_LC_5_2_4.C_ON=1'b0;
    defparam LED2_m0_r_LC_5_2_4.SEQ_MODE=4'b1000;
    defparam LED2_m0_r_LC_5_2_4.LUT_INIT=16'b0000000011111111;
    LogicCell40 LED2_m0_r_LC_5_2_4 (
            .in0(_gnd_net_),
            .in1(_gnd_net_),
            .in2(_gnd_net_),
            .in3(N__2147),
            .lcout(LED2_m0_rZ0),
            .ltout(),
            .carryin(_gnd_net_),
            .carryout(),
            .clk(N__2381),
            .ce(N__2270),
            .sr(_gnd_net_));
    defparam BUT2_r_LC_5_2_6.C_ON=1'b0;
    defparam BUT2_r_LC_5_2_6.SEQ_MODE=4'b1000;
    defparam BUT2_r_LC_5_2_6.LUT_INIT=16'b1111111100000000;
    LogicCell40 BUT2_r_LC_5_2_6 (
            .in0(_gnd_net_),
            .in1(_gnd_net_),
            .in2(_gnd_net_),
            .in3(N__2169),
            .lcout(BUT2_rZ0),
            .ltout(),
            .carryin(_gnd_net_),
            .carryout(),
            .clk(N__2381),
            .ce(N__2270),
            .sr(_gnd_net_));
    defparam clk_div_1_cry_1_c_LC_5_7_0.C_ON=1'b1;
    defparam clk_div_1_cry_1_c_LC_5_7_0.SEQ_MODE=4'b0000;
    defparam clk_div_1_cry_1_c_LC_5_7_0.LUT_INIT=16'b0000000000000000;
    LogicCell40 clk_div_1_cry_1_c_LC_5_7_0 (
            .in0(_gnd_net_),
            .in1(N__2132),
            .in2(N__2115),
            .in3(_gnd_net_),
            .lcout(),
            .ltout(),
            .carryin(bfn_5_7_0_),
            .carryout(clk_div_1_cry_1),
            .clk(_gnd_net_),
            .ce(),
            .sr(_gnd_net_));
    defparam clk_div_2_LC_5_7_1.C_ON=1'b1;
    defparam clk_div_2_LC_5_7_1.SEQ_MODE=4'b1000;
    defparam clk_div_2_LC_5_7_1.LUT_INIT=16'b1001100101100110;
    LogicCell40 clk_div_2_LC_5_7_1 (
            .in0(_gnd_net_),
            .in1(N__2087),
            .in2(_gnd_net_),
            .in3(N__2073),
            .lcout(clk_divZ0Z_2),
            .ltout(),
            .carryin(clk_div_1_cry_1),
            .carryout(clk_div_1_cry_2),
            .clk(N__2379),
            .ce(),
            .sr(_gnd_net_));
    defparam clk_div_3_LC_5_7_2.C_ON=1'b1;
    defparam clk_div_3_LC_5_7_2.SEQ_MODE=4'b1000;
    defparam clk_div_3_LC_5_7_2.LUT_INIT=16'b1001100101100110;
    LogicCell40 clk_div_3_LC_5_7_2 (
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
            .in2(_gnd_net_),
            .in3(_gnd_net_),
            .lcout(BUT1_rZ0),
            .ltout(),
            .carryin(_gnd_net_),
            .carryout(),
            .clk(N__2382),
            .ce(N__2271),
            .sr(_gnd_net_));
endmodule // led_but_ex1
