OLIMEX/iCE40HX1K-EVB/windows/ice40blinkingled/ice40blinkingled_Implmnt/sbt/outputs/simulation_netlist/led_but_ex1_sbt.vhd

-- ******************************************************************************

-- iCEcube Netlister

-- Version:            2015.08.27744

-- Build Date:         Oct 14 2015 00:55:27

-- File Generated:     Jul 18 2016 09:41:18

-- Purpose:            Post-Route Verilog/VHDL netlist for timing simulation

-- Copyright (C) 2006-2010 by Lattice Semiconductor Corp. All rights reserved.

-- ******************************************************************************

-- VHDL file for cell "led_but_ex1" view "INTERFACE"

library ieee;
use ieee.std_logic_1164.all;
use ieee.std_logic_arith.all;
use ieee.std_logic_unsigned.all;

library ice;
use ice.vcomponent_vital.all;

-- Entity of led_but_ex1
entity led_but_ex1 is
port (
    LED2 : out std_logic;
    CLK : in std_logic;
    BUT1 : in std_logic;
    LED1 : out std_logic;
    BUT2 : in std_logic);
end led_but_ex1;

-- Architecture of led_but_ex1
-- View name is \INTERFACE\
architecture \INTERFACE\ of led_but_ex1 is

signal \N__2577\ : std_logic;
signal \N__2576\ : std_logic;
signal \N__2575\ : std_logic;
signal \N__2566\ : std_logic;
signal \N__2565\ : std_logic;
signal \N__2564\ : std_logic;
signal \N__2557\ : std_logic;
signal \N__2556\ : std_logic;
signal \N__2555\ : std_logic;
signal \N__2548\ : std_logic;
signal \N__2547\ : std_logic;
signal \N__2546\ : std_logic;
signal \N__2539\ : std_logic;
signal \N__2538\ : std_logic;
signal \N__2537\ : std_logic;
signal \N__2520\ : std_logic;
signal \N__2519\ : std_logic;
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
signal \GNDG0\ : std_logic;
signal \un1_rst_cnt_1_cry_13_THRU_CRY_0_THRU_CO\ : std_logic;
signal \un1_rst_cnt_1_cry_13_THRU_CRY_1_THRU_CO\ : std_logic;
signal \bfn_2_9_0_\ : std_logic;
signal \rst_cntZ0Z_14\ : std_logic;
signal \N_16_0\ : std_logic;
signal \BUT1_r_RNIKV9MZ0Z2\ : std_logic;
signal \LED2_m1_rZ0\ : std_logic;
signal \LED2_c\ : std_logic;
signal \modeZ0\ : std_logic;
signal \LED1_m1_rZ0\ : std_logic;
signal \LED1_c\ : std_logic;
signal \bfn_4_7_0_\ : std_logic;
signal clk_div_2_cry_1 : std_logic;
signal clk_div_2_cry_2 : std_logic;
signal clk_div_2_cry_3 : std_logic;
signal clk_div_2_cry_4 : std_logic;
signal clk_div_2_cry_5 : std_logic;
signal clk_div_2_cry_6 : std_logic;
signal clk_div_2_cry_7 : std_logic;
signal clk_div_2_cry_8 : std_logic;
signal \bfn_4_8_0_\ : std_logic;
signal clk_div_2_cry_9 : std_logic;
signal clk_div_2_cry_10 : std_logic;
signal \clk_div_RNI06L91Z0Z_11\ : std_logic;
signal clk_div_i_11 : std_logic;
signal \LED1_m0_rZ0\ : std_logic;
signal \LED2_m0_rZ0\ : std_logic;
signal \BUT2_c\ : std_logic;
signal \BUT2_rZ0\ : std_logic;
signal \clk_divZ0Z_1\ : std_logic;
signal \clk_divZ0Z_0\ : std_logic;
signal \bfn_5_7_0_\ : std_logic;
signal \clk_divZ0Z_2\ : std_logic;
signal clk_div_1_cry_1 : std_logic;
signal \clk_divZ0Z_3\ : std_logic;
signal clk_div_1_cry_2 : std_logic;
signal \clk_divZ0Z_4\ : std_logic;
signal clk_div_1_cry_3 : std_logic;
signal \clk_divZ0Z_5\ : std_logic;
signal clk_div_1_cry_4 : std_logic;
signal \clk_divZ0Z_6\ : std_logic;
signal clk_div_1_cry_5 : std_logic;
signal \clk_divZ0Z_7\ : std_logic;
signal clk_div_1_cry_6 : std_logic;
signal \clk_divZ0Z_8\ : std_logic;
signal clk_div_1_cry_7 : std_logic;
signal clk_div_1_cry_8 : std_logic;
signal \clk_divZ0Z_9\ : std_logic;
signal \bfn_5_8_0_\ : std_logic;
signal clk_div_1_cry_9 : std_logic;
signal \clk_divZ0Z_10\ : std_logic;
signal \BUT1_c\ : std_logic;
signal \BUT1_rZ0\ : std_logic;
signal \CLK_c_g\ : std_logic;
signal \N_16_g\ : std_logic;
signal \_gnd_net_\ : std_logic;

signal \CLK_wire\ : std_logic;
signal \BUT2_wire\ : std_logic;
signal \BUT1_wire\ : std_logic;
signal \LED1_wire\ : std_logic;
signal \LED2_wire\ : std_logic;

begin
    \CLK_wire\ <= CLK;
    \BUT2_wire\ <= BUT2;
    \BUT1_wire\ <= BUT1;
    LED1 <= \LED1_wire\;
    LED2 <= \LED2_wire\;

    \CLK_ibuf_gb_io_preiogbuf\ : PRE_IO_GBUF
    port map (
            PADSIGNALTOGLOBALBUFFER => \N__2575\,
            GLOBALBUFFEROUTPUT => \CLK_c_g\
        );

    \CLK_ibuf_gb_io_iopad\ : IO_PAD
    generic map (
            IO_STANDARD => "SB_LVCMOS",
            PULLUP => '0'
        )
    port map (
            OE => \N__2577\,
            DIN => \N__2576\,
            DOUT => \N__2575\,
            PACKAGEPIN => \CLK_wire\
        );

    \CLK_ibuf_gb_io_preio\ : PRE_IO
    generic map (
            NEG_TRIGGER => '0',
            PIN_TYPE => "000001"
        )
    port map (
            PADOEN => \N__2577\,
            PADOUT => \N__2576\,
            PADIN => \N__2575\,
            CLOCKENABLE => 'H',
            DOUT1 => '0',
            OUTPUTENABLE => '0',
            DIN0 => OPEN,
            DOUT0 => '0',
            INPUTCLK => '0',
            LATCHINPUTVALUE => '0',
            DIN1 => OPEN,
            OUTPUTCLK => '0'
        );

    \BUT2_ibuf_iopad\ : IO_PAD
    generic map (
            IO_STANDARD => "SB_LVCMOS",
            PULLUP => '0'
        )
    port map (
            OE => \N__2566\,
            DIN => \N__2565\,
            DOUT => \N__2564\,
            PACKAGEPIN => \BUT2_wire\
        );

    \BUT2_ibuf_preio\ : PRE_IO
    generic map (
            NEG_TRIGGER => '0',
            PIN_TYPE => "000001"
        )
    port map (
            PADOEN => \N__2566\,
            PADOUT => \N__2565\,
            PADIN => \N__2564\,
            CLOCKENABLE => 'H',
            DOUT1 => '0',
            OUTPUTENABLE => '0',
            DIN0 => \BUT2_c\,
            DOUT0 => '0',
            INPUTCLK => '0',
            LATCHINPUTVALUE => '0',
            DIN1 => OPEN,
            OUTPUTCLK => '0'
        );

    \BUT1_ibuf_iopad\ : IO_PAD
    generic map (
            IO_STANDARD => "SB_LVCMOS",
            PULLUP => '0'
        )
    port map (
            OE => \N__2557\,
            DIN => \N__2556\,
            DOUT => \N__2555\,
            PACKAGEPIN => \BUT1_wire\
        );

    \BUT1_ibuf_preio\ : PRE_IO
    generic map (
            NEG_TRIGGER => '0',
            PIN_TYPE => "000001"
        )
    port map (
            PADOEN => \N__2557\,
            PADOUT => \N__2556\,
            PADIN => \N__2555\,
            CLOCKENABLE => 'H',
            DOUT1 => '0',
            OUTPUTENABLE => '0',
            DIN0 => \BUT1_c\,
            DOUT0 => '0',
            INPUTCLK => '0',
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
            in2 => \N__2466\,
            in3 => \_gnd_net_\,
            lcout => OPEN,
            ltout => OPEN,
            carryin => clk_div_2_cry_7,
            carryout => clk_div_2_cry_8,
            clk => \_gnd_net_\,
            ce => 'H',
            sr => \_gnd_net_\
        );

    \clk_div_RNILFN9_9_LC_4_8_0\ : LogicCell40
    generic map (
            C_ON => '1',
            SEQ_MODE => "0000",
            LUT_INIT => "0000000000000000"
        )
    port map (
            in0 => \_gnd_net_\,
            in1 => \_gnd_net_\,
            in2 => \N__2448\,
            in3 => \_gnd_net_\,
            lcout => OPEN,
            ltout => OPEN,
            carryin => \bfn_4_8_0_\,
            carryout => clk_div_2_cry_9,
            clk => \_gnd_net_\,
            ce => 'H',
            sr => \_gnd_net_\
        );

    \clk_div_RNIAAMP_10_LC_4_8_1\ : LogicCell40
    generic map (
            C_ON => '1',
            SEQ_MODE => "0000",
            LUT_INIT => "0000000000000000"
        )
    port map (
            in0 => \_gnd_net_\,
            in1 => \N__2426\,
            in2 => \_gnd_net_\,
            in3 => \_gnd_net_\,
            lcout => OPEN,
            ltout => OPEN,
            carryin => clk_div_2_cry_9,
            carryout => clk_div_2_cry_10,
            clk => \_gnd_net_\,
            ce => 'H',
            sr => \_gnd_net_\
        );

    \clk_div_RNI06L91_11_LC_4_8_2\ : LogicCell40
    generic map (
            C_ON => '0',
            SEQ_MODE => "0000",
            LUT_INIT => "0011001111001100"
        )
    port map (
            in0 => \_gnd_net_\,
            in1 => \N__2192\,
            in2 => \_gnd_net_\,
            in3 => \N__2217\,
            lcout => \clk_div_RNI06L91Z0Z_11\,
            ltout => OPEN,
            carryin => \_gnd_net_\,
            carryout => OPEN,
            clk => \_gnd_net_\,
            ce => 'H',
            sr => \_gnd_net_\
        );

    \clk_div_11_LC_4_8_5\ : LogicCell40
    generic map (
            C_ON => '0',
            SEQ_MODE => "1000",
            LUT_INIT => "1111111100000000"
        )
    port map (
            in0 => \_gnd_net_\,
            in1 => \_gnd_net_\,
            in2 => \_gnd_net_\,
            in3 => \N__2210\,
            lcout => clk_div_i_11,
            ltout => OPEN,
            carryin => \_gnd_net_\,
            carryout => OPEN,
            clk => \N__2372\,
            ce => 'H',
            sr => \_gnd_net_\
        );

    \LED1_m0_r_LC_5_2_1\ : LogicCell40
    generic map (
            C_ON => '0',
            SEQ_MODE => "1000",
            LUT_INIT => "0000000011111111"
        )
    port map (
            in0 => \_gnd_net_\,
            in1 => \_gnd_net_\,
            in2 => \_gnd_net_\,
            in3 => \N__2396\,
            lcout => \LED1_m0_rZ0\,
            ltout => OPEN,
            carryin => \_gnd_net_\,
            carryout => OPEN,
            clk => \N__2381\,
            ce => \N__2270\,
            sr => \_gnd_net_\
        );

    \LED2_m0_r_LC_5_2_4\ : LogicCell40
    generic map (
            C_ON => '0',
            SEQ_MODE => "1000",
            LUT_INIT => "0000000011111111"
        )
    port map (
            in0 => \_gnd_net_\,
            in1 => \_gnd_net_\,
            in2 => \_gnd_net_\,
            in3 => \N__2147\,
            lcout => \LED2_m0_rZ0\,
            ltout => OPEN,
            carryin => \_gnd_net_\,
            carryout => OPEN,
            clk => \N__2381\,
            ce => \N__2270\,
            sr => \_gnd_net_\
        );

    \BUT2_r_LC_5_2_6\ : LogicCell40
    generic map (
            C_ON => '0',
            SEQ_MODE => "1000",
            LUT_INIT => "1111111100000000"
        )
    port map (
            in0 => \_gnd_net_\,
            in1 => \_gnd_net_\,
            in2 => \_gnd_net_\,
            in3 => \N__2169\,
            lcout => \BUT2_rZ0\,
            ltout => OPEN,
            carryin => \_gnd_net_\,
            carryout => OPEN,
            clk => \N__2381\,
            ce => \N__2270\,
            sr => \_gnd_net_\
        );

    \clk_div_1_cry_1_c_LC_5_7_0\ : LogicCell40
    generic map (
            C_ON => '1',
            SEQ_MODE => "0000",
            LUT_INIT => "0000000000000000"
        )
    port map (
            in0 => \_gnd_net_\,
            in1 => \N__2132\,
            in2 => \N__2115\,
            in3 => \_gnd_net_\,
            lcout => OPEN,
            ltout => OPEN,
            carryin => \bfn_5_7_0_\,
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
            in3 => \N__2451\,
            lcout => \clk_divZ0Z_8\,
            ltout => OPEN,
            carryin => clk_div_1_cry_7,
            carryout => clk_div_1_cry_8,
            clk => \N__2379\,
            ce => 'H',
            sr => \_gnd_net_\
        );
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
