OLIMEX/iCE40HX1K-EVB/(commit log)

2016-02-12 initial schematic and pcb location
    [ICE40-1KEVB_Rev_A.kicad_pcb, ICE40-1KEVB_Rev_A.sch]
2016-06-30 Getting Started with ICESTORM, demo, board update
    [iCE40HX1K-EVB_Rev_B.kicad_pcb, iCE40HX1K-EVB_Rev_B.sch]
2016-07-12 update LED blink demo with more comments
2016-07-15 iCE40 modules ADC, DAC, IO, DIO
    [ICE40-ADC_Rev_A.kicad_pcb, ICE40-ADC_Rev_A.sch, ICE40-DAC_Rev_A.kicad_pcb, ICE40-DAC_Rev_A.sch, ICE40-DIO_Rev_A.kicad_pcb, ICE40-DIO_Rev_A.sch, ICE40-IO_Rev_A.kicad_pcb, ICE40-IO_Rev_A.sch]
2016-07-18 add blink LED iCEcube2 project for windows
    [led_but_ex1_pin_table.CSV, led_but_ex1_sbt.sdf, led_but_ex1_sbt_vital.sdf]
2017-07-11 removed duplicates
    [ICE40-ADC_Rev_A.kicad_pcb, ICE40-ADC_Rev_A.sch, ICE40-DAC_Rev_A.kicad_pcb, ICE40-DAC_Rev_A.sch, ICE40-DIO_Rev_A.kicad_pcb, ICE40-DIO_Rev_A.sch, ICE40-IO_Rev_A.kicad_pcb, ICE40-IO_Rev_A.sch]
2018-03-12 Fix spelling errors in comments
    Column and Horizontally.
    [example.v]
2019-01-13 programmer/olimexino-32u4 firmware: make it possible to use PlatformIO
    This commit simplifies firmware build by using PlatformIO (https://platformio.org/).
    PlatformIO makes it possible to build olimexino-32u4 firmware
    using CLI interface without manual Arduino libraries setup.
    SPIFlash library by Prajwal Bhattaram is outdated and is not available
    via current 1.8.8 Arduino IDE. SPIFlash has been superseded by SPIMemory.
    This commit imports SPIFlash 2.2.0 sources from SPIMemory github repo.
    import howto:
    $ git clone -b v2.2.0 https://github.com/Marzogh/SPIMemory
    $ mkdir src
    $ cp SPIMemory/SPIFlash.cpp SPIMemory/SPIFlash.h src/
    Necessary forward declaration are added to iceprog.ino t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
2020-05-26 added UART bridge
2022-04-01 fixing bug with platformio run compilation (undefined loop functions)
    [iceprog.ino]
2023-10-05 Update
    Added pcf files for GPIO1
    [iCE40PinoutHX1K.xlsx]
2026-01-14 Updated
    Added original firmware in case someone has trouble with the edited one (that utilizes buttons).
